eSpark-Backup/ezlo-irblaster/docs/Client's Original Design/irblaster_revB/3D/irblaster_revb_top.png

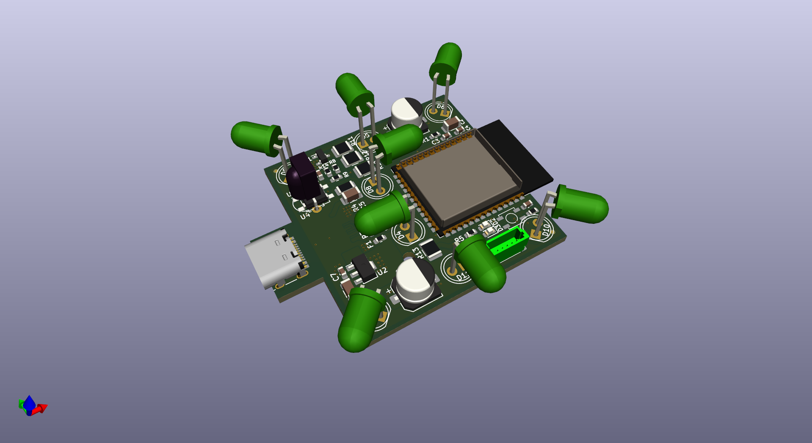
docs/Client's Original Design/irblaster_revB/3D/irblaster_revb_top.png
