eSpark-Backup/ezlo-irblaster/Deliverables/Renderings/3D_Top_View.PNG

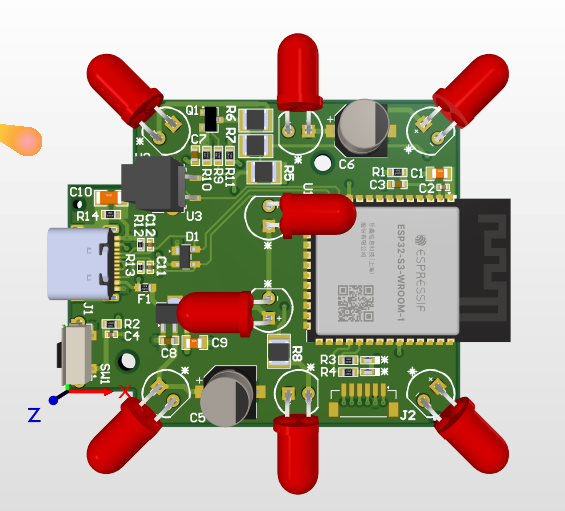
Deliverables/Renderings/3D_Top_View.PNG
