eSpark-Backup/ezlo-irblaster/Deliverables/Renderings/2D_C_View.PNG

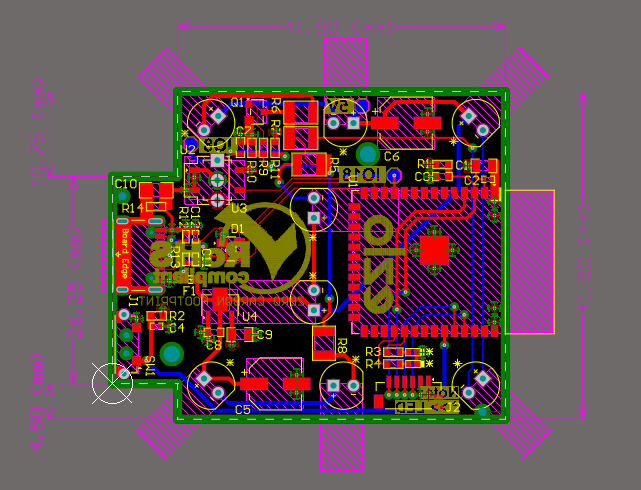
Deliverables/Renderings/2D_C_View.PNG
