eSpark-Backup/ezlo-irblaster/Deliverables/Renderings/3D_Bottom_View.PNG

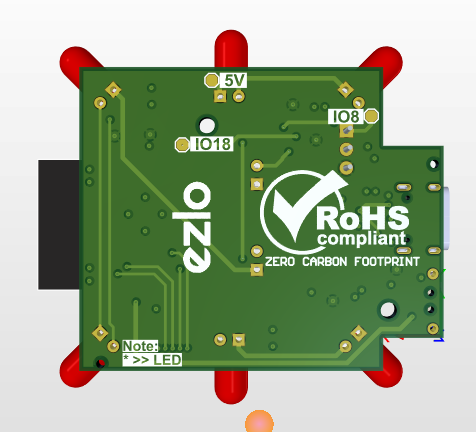
Deliverables/Renderings/3D_Bottom_View.PNG
