eSpark-Backup/ezlo-irblaster/Deliverables/Renderings/3D_Isometric_View.PNG

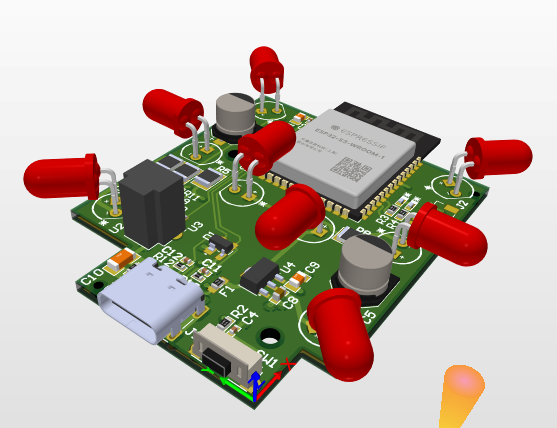
Deliverables/Renderings/3D_Isometric_View.PNG
