eSpark-Backup/ezlo-irblaster/Deliverables/BOM/eSpark_BOM.xlsx

Sheet: 20 Boards
 |  | Component list |  | Bill of Materials for Project [IR_blaster]
 |  | Source Data From: |  | IR_blaster
 |  | Project: |  | IR_blaster
 |  | Variant: |  | None
# | Item Type | Designator | Description | Footprint | Manufacturer Part Number | Manufacturer | Alternate Part Number | LCSC Part Number | Value | Quantity | Quantity (20 Boards) | MOQ (20 Boards) | Links | Unit Cost (20 Boards) | Total Cost (20 Boards) | Remarks | Reviewer Remarks
1 | Capacitor | C1, C9 | CAP CER 22UF 25V X5R 0805 | Cap-0805 | CL21A226MAYNNNE | Samsung | - | C602037 | 22uF | 2 | 40 | 60 | LCSC (https://www.lcsc.com/product-detail/Multilayer-Ceramic-Capacitors-MLCC-SMD-SMT_Samsung-Electro-Mechanics-CL21A226MAYNNNE_C602037.html) | $0.0235 | $1.4100
2 | Capacitor | C2, C4 | CAP CER 0.1UF 50V X5R 0402 | Cap-0402 | ~~C1005X5R1H104K050BB~~ | TDK | 0402B104K500CT | C152814 | 0.1uF | 2 | 40 | 100 | LCSC (https://www.lcsc.com/product-detail/Multilayer-Ceramic-Capacitors-MLCC-SMD-SMT_Walsin-Tech-Corp-0402B104K500CT_C152814.html) | $0.0020 | $0.2000
3 | Capacitor | C3 | CAP CER 1UF 25V X5R 0603 | Cap-0603 | CC0603KRX5R8BB105 | Yageo |  | C14664 | 1uF | 1 | 20 | 100 | LCSC (https://www.lcsc.com/product-detail/Multilayer-Ceramic-Capacitors-MLCC-SMD-SMT_YAGEO-CC0603KRX5R8BB105_C14664.html) | $0.0046 | $0.4600
4 | Capacitor | C5, C6 | 220uF 5.4mm 10V 6.3mm ±20% SMD,D6.3xL5.4mm Aluminum Electrolytic Capacitors - SMD ROHS | Custom | RT1A221M0605 | ROQANG | - | C267466 | 220uF | 2 | 40 | 60 | LCSC (https://www.lcsc.com/product-detail/Aluminum-Electrolytic-Capacitors-SMD_ROQANG-RT1A221M0605_C267466.html) | $0.0329 | $1.9740
5 | Capacitor | C7 | CAP CER 4.7UF 25V X5R 0603 | Cap-0603 | CL10A475KA8NQNC | Samsung | - | C69335 | 4.7UF | 1 | 20 | 40 | LCSC (https://www.lcsc.com/product-detail/Multilayer-Ceramic-Capacitors-MLCC-SMD-SMT_Samsung-Electro-Mechanics-CL10A475KA8NQNC_C69335.html) | $0.0173 | $0.6920
6 | Capacitor | C8 | CAP CER 10UF 25V X5R 0603 | Cap-0603 | ~~C1608X5R1E106M080AC~~ | TDK | CL10A106MA8NRNC | C96446 | 10uF | 1 | 20 | 40 | LCSC (https://www.lcsc.com/product-detail/Multilayer-Ceramic-Capacitors-MLCC-SMD-SMT_Samsung-Electro-Mechanics-CL10A106MA8NRNC_C96446.html) | $0.0234 | $0.9360
7 | Capacitor | C10 | CAP CER 4700PF 1KV X7R 1206 | Cap-1206 | CC1206KKX7RCBB472 | Yageo |  | C107198 | 4.7nF | 1 | 20 | 50 | LCSC (https://www.lcsc.com/product-detail/Multilayer-Ceramic-Capacitors-MLCC-SMD-SMT_YAGEO-CC1206KKX7RCBB472_C107198.html) | $0.0148 | $0.7400
8 | Capacitor | C11, C12 | DO Not Mount | Cap-0402 | - | - | - | - | - | 2 | 40 | - | - | - | - | DO NOT MOUNT
9 | Diode | D1 | ESD Suppressor TVS 5.5V 4-Pin(3+Tab) SOT-143 T/R | SOT-143-4_ | SP0503BAHTG | Littelfuse | - | C7074 | - | 1 | 20 | 25 | LCSC (https://www.lcsc.com/product-detail/TVS_Littelfuse-SP0503BAHTG_C7074.html) | $0.1760 | $4.4000
10 | Fuse | F1 | 6V 1A 50A 1W -40℃~+85℃ 2A 9mΩ 0.5s 80mΩ 0603 Resettable Fuses ROHS | fuse-0603 | BSMD0603L-100 | BHFUSE | - | C2757929 | - | 1 | 20 | 25 | LCSC (https://www.lcsc.com/product-detail/Resettable-Fuses_BHFUSE-BSMD0603L-100_C2757929.html) | $0.0716 | $1.7900
11 | Connector | J1 | 250mA 1 16 Female Type-C SMD USB Connectors ROHS | Custom | TYPE-C-31-M-12 | Korean Hroparts Elec | - | C165948 | - | 1 | 20 | 25 | LCSC (https://www.lcsc.com/product-detail/USB-Connectors_Korean-Hroparts-Elec-TYPE-C-31-M-12_C165948.html) | $0.2276 | $5.6900
12 | JST Connector | J2 | DNP | Custom | Voltlink Target | - | - | - | - | 1 | 20 | - | - | - | - | DO NOT MOUNT
13 | LED | LED1 | Green 520~535nm 0402 Light Emitting Diodes (LED) RoHS | LED-0402 | 16-213/GHC-YR1S1/3T | Everlight Elec | - | C74338 | - | 1 | 20 | 30 | LCSC (https://www.lcsc.com/product-detail/Light-Emitting-Diodes-LED_Everlight-Elec-16-213-GHC-YR1S1-3T_C74338.html) | $0.0660 | $1.9800
14 | LED | LED2 | LED RED CLEAR CHIP SMD | LED-0402 | ~~XZMDK68W-2~~ | SunLED | XL-1005SURC | C965790 | - | 1 | 20 | 100 | LCSC (https://www.lcsc.com/product-detail/Light-Emitting-Diodes-span-style-background-color-ff0-LED-span_XINGLIGHT-XL-1005SURC_C965790.html) | $0.0059 | $0.5900
15 | Infrared LED | LED3, LED4, LED5, LED6, LED7, LED8, LED9, LED10 | EMITTER IR 940NM 100MA RADIAL | IR333_A | IR333-A | Everlight | - | C95407 | - | 8 | 160 | 180 | LCSC (https://www.lcsc.com/product-detail/Infrared-IR-LEDs_Everlight-Elec-IR333-A_C95407.html) | $0.0481 | $8.6580
16 | Test Point | P2, P3, P4 | Test Point ON | Custom | - | - | - | - | - | 3 | 60 | - | - | - | - | DO NOT MOUNT
17 | Mosfet | Q1 | 20V 3A 40mΩ@4.5V,3A 700mW 780mV@250uA 29pF@10V N Channel 280pF@10V 2.9nC@4.5V -55℃~+150℃@(Tj) SOT-23-3L MOSFETs ROHS | SOT-23-3L_ | YJL2302B | Yangzhou Yangjie Elec Tech | - | C699316 | - | 1 | 20 | 40 | LCSC (https://www.lcsc.com/product-detail/MOSFETs_Yangzhou-Yangjie-Elec-Tech-YJL2302B_C699316.html) | $0.0287 | $1.1480
18 | Resistor | R1, R2, R10 | RES SMD 10K OHM 5% 1/5W 0603 | RES-0603 | ~~CRGH0603J10K~~ | TE Connectivity Holsworthy | CR0603JA0103G | C101254 | 10K | 3 | 60 | 100 | LCSC (https://www.lcsc.com/product-detail/Chip-Resistor-Surface-Mount_LIZ-Elec-CR0603JA0103G_C101254.html) | $0.0010 | $0.1000
19 | Resistor | R3, R4 | RES SMD 330R 100 mW 0603 | Res-0603 | RC0603JR-07330RL | Yageo | - | C105879 | 330R | 2 | 40 | 100 | LCSC (https://www.lcsc.com/product-detail/Chip-Resistor-Surface-Mount_YAGEO-RC0603JR-07330RL_C105879.html) | $0.0011 | $0.1100
20 | Resistor | R5, R6, R7, R8 | 500mW Thick Film Resistors 200V ±100ppm/℃ 27Ω 1210 Chip Resistor - SMD ROHS | Res_1210 | FRC1210F27R0TS | FOJAN | - | C2960734 | 27R | 4 | 80 | 100 | LCSC (https://www.lcsc.com/product-detail/Chip-Resistor-Surface-Mount_FOJAN-FRC1210F27R0TS_C2960734.html) | $0.0088 | $0.8800
21 | Resistor | R9, R11 | RES SMD 100 OHM 1% 1/10W 0603 | Res-0603 | RC0603FR-07100RL | Yageo |  | C105588 | 100R | 2 | 40 | 100 | LCSC (https://www.lcsc.com/product-detail/Chip-Resistor-Surface-Mount_YAGEO-RC0603FR-07100RL_C105588.html) | $0.0009 | $0.0900
22 | Resistor | R12, R13 | RES SMD 5.1 KOHM 1% 1/5W 0402 | Res-0402 | ~~ERJ-PA2F5101X~~ | Panasonic | RC-02W5101FT | C294638 | 5.1K | 2 | 40 | 100 | LCSC (https://www.lcsc.com/product-detail/Chip-Resistor-Surface-Mount_FH-Guangdong-Fenghua-Advanced-Tech-RC-02W5101FT_C294638.html) | $0.0004 | $0.0400
23 | Resistor | R14 | RES SMD 1M OHM 1% 1/10W 0603 | Res-0603 | RC0603FR-071ML | Yageo |  | C105578 | 1M | 1 | 20 | 100 | LCSC (https://www.lcsc.com/product-detail/Chip-Resistor-Surface-Mount_YAGEO-RC0603FR-071ML_C105578.html) | $0.0015 | $0.1500
24 | Switch | SW1 | 3.5mm 3.5mm SMDSplicing Black Rectangle button 50mA Surface Mount 7mm SPST 100MΩ 20000 12V 250gf@±50gf SMD Tactile Switches ROHS | Custom | YTS-B003-2A | YIYUAN | - | C2910695 | - | 1 | 20 | 40 | LCSC (https://www.lcsc.com/product-detail/Tactile-Switches_YIYUAN-YTS-B003-2A_C2910695.html) | $0.0180 | $0.7200
25 | Module | U1 | SMD MODULE, ESP32-S3, 4 MB SPI F | 41-SMD Module | ESP32-S3-WROOM-1-N4 | Espressif Systems | - | C2913197 | - | 1 | 20 | 22 | LCSC (https://www.lcsc.com/product-detail/WiFi-Modules_Espressif-Systems-ESP32-S3-WROOM-1-N4_C2913197.html) | $3.4046 | $74.9012
26 | IC | U2 | IRM-H6 Series External Dimensions 5 x 7 x 4 mm SMT Infrared Receiver | SMD-4,4x5mm | IRM-H638T/TR2 | Everlight | - | C91447 | - | 1 | 20 | 25 | LCSC (https://www.lcsc.com/product-detail/Infrared-remote-receiver_Everlight-Elec-IRM-H638T-TR2_C91447.html) | $0.2901 | $7.2525
27 | IC | U3 | SENSOR REMOTE REC 38.0KHZ 14M | SIP-3P-2.54mm | IRM-3638T | Everlight | - | C16216 | - | 1 | 20 | 25 | LCSC (https://www.lcsc.com/product-detail/Infrared-remote-receiver_Everlight-Elec-IRM-3638T_C16216.html) | $0.2118 | $5.2950
28 | IC | U4 | 600mA 60dB 500mV@(600mA) Fixed 3.3V~3.3V Positive 1 7V SOT-89(SOT-89-3) Linear Voltage Regulators (LDO) ROHS | SOT-89-3 | LR1107G-33-AB3-C-R | UTC(Unisonic Tech) | - | C171498 | - | 1 | 20 | 22 | LCSC (https://www.lcsc.com/product-detail/Linear-Voltage-Regulators-LDO_UTC-Unisonic-Tech-LR1107G-33-AB3-C-R_C171498.html) | $0.1418 | $3.1196
 |  |  |  |  |  |  |  |  |  |  |  | Total Component Cost |  |  | $123.33
 |  |  |  |  |  |  |  |  |  |  |  | Single Board Cost |  |  | $6.17

Sheet: 1000 Boards
 |  | Component list |  | Bill of Materials for Project [IR_blaster]
 |  | Source Data From: |  | IR_blaster
 |  | Project: |  | IR_blaster
 |  | Variant: |  | None
# | Item Type | Designator | Description | Footprint | Manufacturer Part Number | Manufacturer | Alternate Part Number | LCSC Part Number | Value | Quantity | Quantity (1000 Boards) | MOQ (1000 Boards) | Links | Unit Cost (1000 Boards) | Total Cost (1000 Boards) | Remarks | Reviewer Remarks
1 | Capacitor | C1, C9 | CAP CER 22UF 25V X5R 0805 | Cap-0805 | CL21A226MAYNNNE | Samsung | - | C602037 | 22uF | 2 | 2000 | 1060 | LCSC (https://www.lcsc.com/product-detail/Multilayer-Ceramic-Capacitors-MLCC-SMD-SMT_Samsung-Electro-Mechanics-CL21A226MAYNNNE_C602037.html) | $0.0156 | $16.5360
2 | Capacitor | C2, C4 | CAP CER 0.1UF 50V X5R 0402 | Cap-0402 | ~~C1005X5R1H104K050BB~~ | TDK | 0402B104K500CT | C152814 | 0.1uF | 2 | 2000 | 2100 | LCSC (https://www.lcsc.com/product-detail/Multilayer-Ceramic-Capacitors-MLCC-SMD-SMT_Walsin-Tech-Corp-0402B104K500CT_C152814.html) | $0.0015 | $3.1500
3 | Capacitor | C3 | CAP CER 1UF 25V X5R 0603 | Cap-0603 | CC0603KRX5R8BB105 | Yageo |  | C14664 | 1uF | 1 | 1000 | 1100 | LCSC (https://www.lcsc.com/product-detail/Multilayer-Ceramic-Capacitors-MLCC-SMD-SMT_YAGEO-CC0603KRX5R8BB105_C14664.html) | $0.0036 | $3.9600
4 | Capacitor | C5, C6 | 220uF 5.4mm 10V 6.3mm ±20% SMD,D6.3xL5.4mm Aluminum Electrolytic Capacitors - SMD ROHS | Custom | RT1A221M0605 | ROQANG | - | C267466 | 220uF | 2 | 2000 | 2060 | LCSC (https://www.lcsc.com/product-detail/Aluminum-Electrolytic-Capacitors-SMD_ROQANG-RT1A221M0605_C267466.html) | $0.0210 | $43.2600
5 | Capacitor | C7 | CAP CER 4.7UF 25V X5R 0603 | Cap-0603 | CL10A475KA8NQNC | Samsung | - | C69335 | 4.7UF | 1 | 1000 | 1060 | LCSC (https://www.lcsc.com/product-detail/Multilayer-Ceramic-Capacitors-MLCC-SMD-SMT_Samsung-Electro-Mechanics-CL10A475KA8NQNC_C69335.html) | $0.0120 | $12.7200
6 | Capacitor | C8 | CAP CER 10UF 25V X5R 0603 | Cap-0603 | ~~C1608X5R1E106M080AC~~ | TDK | CL10A106MA8NRNC | C96446 | 10uF | 1 | 1000 | 1060 | LCSC (https://www.lcsc.com/product-detail/Multilayer-Ceramic-Capacitors-MLCC-SMD-SMT_Samsung-Electro-Mechanics-CL10A106MA8NRNC_C96446.html) | $0.0158 | $16.7480
7 | Capacitor | C10 | CAP CER 4700PF 1KV X7R 1206 | Cap-1206 | CC1206KKX7RCBB472 | Yageo |  | C107198 | 4.7nF | 1 | 1000 | 1050 | LCSC (https://www.lcsc.com/product-detail/Multilayer-Ceramic-Capacitors-MLCC-SMD-SMT_YAGEO-CC1206KKX7RCBB472_C107198.html) | $0.0120 | $12.6000
8 | Capacitor | C11, C12 | DO Not Mount | Cap-0402 | - | - | - | - | - | 2 | 2000 |  | - |  | - | DO NOT MOUNT
9 | Diode | D1 | ESD Suppressor TVS 5.5V 4-Pin(3+Tab) SOT-143 T/R | SOT-143-4_ | SP0503BAHTG | Littelfuse | - | C7074 | - | 1 | 1000 | 1050 | LCSC (https://www.lcsc.com/product-detail/TVS_Littelfuse-SP0503BAHTG_C7074.html) | $0.1196 | $125.5800
10 | Fuse | F1 | 6V 1A 50A 1W -40℃~+85℃ 2A 9mΩ 0.5s 80mΩ 0603 Resettable Fuses ROHS | fuse-0603 | BSMD0603L-100 | BHFUSE | - | C2757929 | - | 1 | 1000 | 1050 | LCSC (https://www.lcsc.com/product-detail/Resettable-Fuses_BHFUSE-BSMD0603L-100_C2757929.html) | $0.0471 | $49.4550
11 | Connector | J1 | 250mA 1 16 Female Type-C SMD USB Connectors ROHS | Custom | TYPE-C-31-M-12 | Korean Hroparts Elec | - | C165948 | - | 1 | 1000 | 1050 | LCSC (https://www.lcsc.com/product-detail/USB-Connectors_Korean-Hroparts-Elec-TYPE-C-31-M-12_C165948.html) | $0.1074 | $112.7700
12 | JST Connector | J2 | DNP | Custom | Voltlink Target | - | - | - | - | 1 | 1000 | - | - | - | - | DO NOT MOUNT
13 | LED | LED1 | Green 520~535nm 0402 Light Emitting Diodes (LED) RoHS | LED-0402 | 16-213/GHC-YR1S1/3T | Everlight Elec | - | C74338 | - | 1 | 1000 | 1050 | LCSC (https://www.lcsc.com/product-detail/Light-Emitting-Diodes-LED_Everlight-Elec-16-213-GHC-YR1S1-3T_C74338.html) | $0.0488 | $51.2400
14 | LED | LED2 | LED RED CLEAR CHIP SMD | LED-0402 | ~~XZMDK68W-2~~ | SunLED | XL-1005SURC | C965790 | - | 1 | 1000 | 1100 | LCSC (https://www.lcsc.com/product-detail/Light-Emitting-Diodes-span-style-background-color-ff0-LED-span_XINGLIGHT-XL-1005SURC_C965790.html) | $0.0047 | $5.1700
15 | Infrared LED | LED3, LED4, LED5, LED6, LED7, LED8, LED9, LED10 | EMITTER IR 940NM 100MA RADIAL | IR333_A | IR333-A | Everlight | - | C95407 | - | 8 | 8000 | 1050 | LCSC (https://www.lcsc.com/product-detail/Infrared-IR-LEDs_Everlight-Elec-IR333-A_C95407.html) | $0.0387 | $40.6350
16 | Test Point | P2, P3, P4 | Test Point ON | Custom | - | - | - | - | - | 3 | 3000 |  | - |  | - | DO NOT MOUNT
17 | Mosfet | Q1 | 20V 3A 40mΩ@4.5V,3A 700mW 780mV@250uA 29pF@10V N Channel 280pF@10V 2.9nC@4.5V -55℃~+150℃@(Tj) SOT-23-3L MOSFETs ROHS | SOT-23-3L_ | YJL2302B | Yangzhou Yangjie Elec Tech | - | C699316 | - | 1 | 1000 | 1040 | LCSC (https://www.lcsc.com/product-detail/MOSFETs_Yangzhou-Yangjie-Elec-Tech-YJL2302B_C699316.html) | $0.0199 | $20.6960
18 | Resistor | R1, R2, R10 | RES SMD 10K OHM 5% 1/5W 0603 | RES-0603 | ~~CRGH0603J10K~~ | TE Connectivity Holsworthy | CR0603JA0103G | C101254 | 10K | 3 | 3000 | 3100 | LCSC (https://www.lcsc.com/product-detail/Chip-Resistor-Surface-Mount_LIZ-Elec-CR0603JA0103G_C101254.html) | $0.0008 | $2.4800
19 | Resistor | R3, R4 | RES SMD 330R 100 mW 0603 | Res-0603 | RC0603JR-07330RL | Yageo | - | C105879 | 330R | 2 | 2000 | 2100 | LCSC (https://www.lcsc.com/product-detail/Chip-Resistor-Surface-Mount_YAGEO-RC0603JR-07330RL_C105879.html) | $0.0008 | $1.6800
20 | Resistor | R5, R6, R7, R8 | 500mW Thick Film Resistors 200V ±100ppm/℃ 27Ω 1210 Chip Resistor - SMD ROHS | Res_1210 | FRC1210F27R0TS | FOJAN | - | C2960734 | 27R | 4 | 4000 | 4050 | LCSC (https://www.lcsc.com/product-detail/Chip-Resistor-Surface-Mount_FOJAN-FRC1210F27R0TS_C2960734.html) | $0.0061 | $24.7050
21 | Resistor | R9, R11 | RES SMD 100 OHM 1% 1/10W 0603 | Res-0603 | RC0603FR-07100RL | Yageo | - | C105588 | 100R | 2 | 2000 | 2100 | LCSC (https://www.lcsc.com/product-detail/Chip-Resistor-Surface-Mount_YAGEO-RC0603FR-07100RL_C105588.html) | $0.0007 | $1.4700
22 | Resistor | R12, R13 | RES SMD 5.1 KOHM 1% 1/5W 0402 | Res-0402 | ~~ERJ-PA2F5101X~~ | Panasonic | RC-02W5101FT | C294638 | 5.1K | 2 | 2000 | 2100 | LCSC (https://www.lcsc.com/product-detail/Chip-Resistor-Surface-Mount_FH-Guangdong-Fenghua-Advanced-Tech-RC-02W5101FT_C294638.html) | $0.0004 | $0.8400
23 | Resistor | R14 | RES SMD 1M OHM 1% 1/10W 0603 | Res-0603 | RC0603FR-071ML | Yageo | - | C105578 | 1M | 1 | 1000 | 1100 | LCSC (https://www.lcsc.com/product-detail/Chip-Resistor-Surface-Mount_YAGEO-RC0603FR-071ML_C105578.html) | $0.0012 | $1.3200
24 | Switch | SW1 | 3.5mm 3.5mm SMDSplicing Black Rectangle button 50mA Surface Mount 7mm SPST 100MΩ 20000 12V 250gf@±50gf SMD Tactile Switches ROHS | Custom | YTS-B003-2A | YIYUAN | - | C2910695 | - | 1 | 1000 | 1060 | LCSC (https://www.lcsc.com/product-detail/Tactile-Switches_YIYUAN-YTS-B003-2A_C2910695.html) | $0.0122 | $12.9320
25 | Module | U1 | SMD MODULE, ESP32-S3, 4 MB SPI F | 41-SMD Module | ESP32-S3-WROOM-1-N4 | Espressif Systems | - | C2913197 | - | 1 | 1000 | 1020 | LCSC (https://www.lcsc.com/product-detail/WiFi-Modules_Espressif-Systems-ESP32-S3-WROOM-1-N4_C2913197.html) | $3.3330 | $3399.6600 | Less Stock On LCSC ETA request sended
26 | IC | U2 | IRM-H6 Series External Dimensions 5 x 7 x 4 mm SMT Infrared Receiver | SMD-4,4x5mm | IRM-H638T/TR2 | Everlight | - | C91447 | - | 1 | 1000 | 1030 | LCSC (https://www.lcsc.com/product-detail/Infrared-remote-receiver_Everlight-Elec-IRM-H638T-TR2_C91447.html) | $0.1737 | $178.9110
27 | IC | U3 | SENSOR REMOTE REC 38.0KHZ 14M | SIP-3P-2.54mm | IRM-3638T | Everlight | - | C16216 | - | 1 | 1000 | 1030 | LCSC (https://www.lcsc.com/product-detail/Infrared-remote-receiver_Everlight-Elec-IRM-3638T_C16216.html) | $0.1326 | $136.5780
28 | IC | U4 | 600mA 60dB 500mV@(600mA) Fixed 3.3V~3.3V Positive 1 7V SOT-89(SOT-89-3) Linear Voltage Regulators (LDO) ROHS | SOT-89-3 | LR1107G-33-AB3-C-R | UTC(Unisonic Tech) | - | C171498 | - | 1 | 1000 | 1030 | LCSC (https://www.lcsc.com/product-detail/Linear-Voltage-Regulators-LDO_UTC-Unisonic-Tech-LR1107G-33-AB3-C-R_C171498.html) | $0.0960 | $98.8800
 |  |  |  |  |  |  |  |  |  |  |  | Total Component Cost |  |  | $4373.98
 |  |  |  |  |  |  |  |  |  |  |  | Single Board Cost |  |  | $4.37

Sheet: 5000 Boards
 |  | Component list |  | Bill of Materials for Project [IR_blaster]
 |  | Source Data From: |  | IR_blaster
 |  | Project: |  | IR_blaster
 |  | Variant: |  | None
# | Item Type | Designator | Description | Footprint | Manufacturer Part Number | Manufacturer | Alternate Part Number | LCSC Part Number | Value | Quantity | Quantity (5000 Boards) | MOQ (5000 Boards) | Links | Unit Cost (5000 Boards) | Total Cost (5000 Boards) | Remarks | Reviewer Remarks
1 | Capacitor | C1, C9 | CAP CER 22UF 25V X5R 0805 | Cap-0805 | CL21A226MAYNNNE | Samsung | - | C602037 | 22uF | 2 | 10000 | 10100 | LCSC (https://www.lcsc.com/product-detail/Multilayer-Ceramic-Capacitors-MLCC-SMD-SMT_Samsung-Electro-Mechanics-CL21A226MAYNNNE_C602037.html) | $0.0130 | $131.3000
2 | Capacitor | C2, C4 | CAP CER 0.1UF 50V X5R 0402 | Cap-0402 | ~~C1005X5R1H104K050BB~~ | TDK | 0402B104K500CT | C152814 | 0.1uF | 2 | 10000 | 10100 | LCSC (https://www.lcsc.com/product-detail/Multilayer-Ceramic-Capacitors-MLCC-SMD-SMT_Walsin-Tech-Corp-0402B104K500CT_C152814.html) | $0.0011 | $11.1100
3 | Capacitor | C3 | CAP CER 1UF 25V X5R 0603 | Cap-0603 | CC0603KRX5R8BB105 | Yageo |  | C14664 | 1uF | 1 | 5000 | 5100 | LCSC (https://www.lcsc.com/product-detail/Multilayer-Ceramic-Capacitors-MLCC-SMD-SMT_YAGEO-CC0603KRX5R8BB105_C14664.html) | $0.0032 | $16.3200
4 | Capacitor | C5, C6 | 220uF 5.4mm 10V 6.3mm ±20% SMD,D6.3xL5.4mm Aluminum Electrolytic Capacitors - SMD ROHS | Custom | RT1A221M0605 | ROQANG | - | C267466 | 220uF | 2 | 10000 | 10100 | LCSC (https://www.lcsc.com/product-detail/Aluminum-Electrolytic-Capacitors-SMD_ROQANG-RT1A221M0605_C267466.html) | $0.0191 | $192.9100
5 | Capacitor | C7 | CAP CER 4.7UF 25V X5R 0603 | Cap-0603 | CL10A475KA8NQNC | Samsung | - | C69335 | 4.7UF | 1 | 5000 | 5100 | LCSC (https://www.lcsc.com/product-detail/Multilayer-Ceramic-Capacitors-MLCC-SMD-SMT_Samsung-Electro-Mechanics-CL10A475KA8NQNC_C69335.html) | $0.0108 | $55.0800
6 | Capacitor | C8 | CAP CER 10UF 25V X5R 0603 | Cap-0603 | ~~C1608X5R1E106M080AC~~ | TDK | CL10A106MA8NRNC | C96446 | 10uF | 1 | 5000 | 5100 | LCSC (https://www.lcsc.com/product-detail/Multilayer-Ceramic-Capacitors-MLCC-SMD-SMT_Samsung-Electro-Mechanics-CL10A106MA8NRNC_C96446.html) | $0.0140 | $71.4000
7 | Capacitor | C10 | CAP CER 4700PF 1KV X7R 1206 | Cap-1206 | CC1206KKX7RCBB472 | Yageo |  | C107198 | 4.7nF | 1 | 5000 | 5100 | LCSC (https://www.lcsc.com/product-detail/Multilayer-Ceramic-Capacitors-MLCC-SMD-SMT_YAGEO-CC1206KKX7RCBB472_C107198.html) | $0.0105 | $53.5500
8 | Capacitor | C11, C12 | DO Not Mount | Cap-0402 | - | - | - | - | - | 2 | 10000 | - | - | - | - | DO NOT MOUNT
9 | Diode | D1 | ESD Suppressor TVS 5.5V 4-Pin(3+Tab) SOT-143 T/R | SOT-143-4_ | SP0503BAHTG | Littelfuse | - | C7074 | - | 1 | 5000 | 5050 | LCSC (https://www.lcsc.com/product-detail/TVS_Littelfuse-SP0503BAHTG_C7074.html) | $0.1128 | $569.6400
10 | Fuse | F1 | 6V 1A 50A 1W -40℃~+85℃ 2A 9mΩ 0.5s 80mΩ 0603 Resettable Fuses ROHS | fuse-0603 | BSMD0603L-100 | BHFUSE | - | C2757929 | - | 1 | 5000 | 5050 | LCSC (https://www.lcsc.com/product-detail/Resettable-Fuses_BHFUSE-BSMD0603L-100_C2757929.html) | $0.0413 | $208.5650
11 | Connector | J1 | 250mA 1 16 Female Type-C SMD USB Connectors ROHS | Custom | TYPE-C-31-M-12 | Korean Hroparts Elec | - | C165948 | - | 1 | 5000 | 5050 | LCSC (https://www.lcsc.com/product-detail/USB-Connectors_Korean-Hroparts-Elec-TYPE-C-31-M-12_C165948.html) | $0.1023 | $516.6150
12 | JST Connector | J2 | DNP | Custom | Voltlink Target | - | - | - | - | 1 | 5000 | - | - | - | - | DO NOT MOUNT
13 | LED | LED1 | Green 520~535nm 0402 Light Emitting Diodes (LED) RoHS | LED-0402 | 16-213/GHC-YR1S1/3T | Everlight Elec | - | C74338 | - | 1 | 5000 | 5050 | LCSC (https://www.lcsc.com/product-detail/Light-Emitting-Diodes-LED_Everlight-Elec-16-213-GHC-YR1S1-3T_C74338.html) | $0.0445 | $224.7250 | Less Stock On LCSC ETA request sended
14 | LED | LED2 | LED RED CLEAR CHIP SMD | LED-0402 | ~~XZMDK68W-2~~ | SunLED | XL-1005SURC | C965790 | - | 1 | 5000 | 5100 | LCSC (https://www.lcsc.com/product-detail/Light-Emitting-Diodes-span-style-background-color-ff0-LED-span_XINGLIGHT-XL-1005SURC_C965790.html) | $0.0040 | $20.4000
15 | Infrared LED | LED3, LED4, LED5, LED6, LED7, LED8, LED9, LED10 | EMITTER IR 940NM 100MA RADIAL | IR333_A | IR333-A | Everlight | - | C95407 | - | 8 | 40000 | 40100 | LCSC (https://www.lcsc.com/product-detail/Infrared-IR-LEDs_Everlight-Elec-IR333-A_C95407.html) | $0.0338 | $1355.3800 | Less Stock On LCSC ETA request sended
16 | Test Point | P2, P3, P4 | Test Point ON | Custom | - | - | - | - | - | 3 | 15000 | - | - | - | - | DO NOT MOUNT
17 | Mosfet | Q1 | 20V 3A 40mΩ@4.5V,3A 700mW 780mV@250uA 29pF@10V N Channel 280pF@10V 2.9nC@4.5V -55℃~+150℃@(Tj) SOT-23-3L MOSFETs ROHS | SOT-23-3L_ | YJL2302B | Yangzhou Yangjie Elec Tech | - | C699316 | - | 1 | 5000 | 5060 | LCSC (https://www.lcsc.com/product-detail/MOSFETs_Yangzhou-Yangjie-Elec-Tech-YJL2302B_C699316.html) | $0.0181 | $91.5860
18 | Resistor | R1, R2, R10 | RES SMD 10K OHM 5% 1/5W 0603 | RES-0603 | ~~CRGH0603J10K~~ | TE Connectivity Holsworthy | CR0603JA0103G | C101254 | 10K | 3 | 15000 | 15100 | LCSC (https://www.lcsc.com/product-detail/Chip-Resistor-Surface-Mount_LIZ-Elec-CR0603JA0103G_C101254.html) | $0.0006 | $9.0600
19 | Resistor | R3, R4 | RES SMD 330R 100 mW 0603 | Res-0603 | RC0603JR-07330RL | Yageo | - | C105879 | 330R | 2 | 10000 | 10100 | LCSC (https://www.lcsc.com/product-detail/Chip-Resistor-Surface-Mount_YAGEO-RC0603JR-07330RL_C105879.html) | $0.0007 | $7.0700
20 | Resistor | R5, R6, R7, R8 | 500mW Thick Film Resistors 200V ±100ppm/℃ 27Ω 1210 Chip Resistor - SMD ROHS | Res_1210 | FRC1210F27R0TS | FOJAN | - | C2960734 | 27R | 4 | 20000 | 20100 | LCSC (https://www.lcsc.com/product-detail/Chip-Resistor-Surface-Mount_FOJAN-FRC1210F27R0TS_C2960734.html) | $0.0055 | $110.5500 | Less Stock On LCSC ETA request sended
21 | Resistor | R9, R11 | RES SMD 100 OHM 1% 1/10W 0603 | Res-0603 | RC0603FR-07100RL | Yageo | - | C105588 | 100R | 2 | 10000 | 10100 | LCSC (https://www.lcsc.com/product-detail/Chip-Resistor-Surface-Mount_YAGEO-RC0603FR-07100RL_C105588.html) | $0.0006 | $6.0600
22 | Resistor | R12, R13 | RES SMD 5.1 KOHM 1% 1/5W 0402 | Res-0402 | ~~ERJ-PA2F5101X~~ | Panasonic | RC-02W5101FT | C294638 | 5.1K | 2 | 10000 | 10100 | LCSC (https://www.lcsc.com/product-detail/Chip-Resistor-Surface-Mount_FH-Guangdong-Fenghua-Advanced-Tech-RC-02W5101FT_C294638.html) | $0.0004 | $4.0400
23 | Resistor | R14 | RES SMD 1M OHM 1% 1/10W 0603 | Res-0603 | RC0603FR-071ML | Yageo | - | C105578 | 1M | 1 | 5000 | 5100 | LCSC (https://www.lcsc.com/product-detail/Chip-Resistor-Surface-Mount_YAGEO-RC0603FR-071ML_C105578.html) | $0.0011 | $5.6100
24 | Switch | SW1 | 3.5mm 3.5mm SMDSplicing Black Rectangle button 50mA Surface Mount 7mm SPST 100MΩ 20000 12V 250gf@±50gf SMD Tactile Switches ROHS | Custom | YTS-B003-2A | YIYUAN | - | C2910695 | - | 1 | 5000 | 5060 | LCSC (https://www.lcsc.com/product-detail/Tactile-Switches_YIYUAN-YTS-B003-2A_C2910695.html) | $0.0110 | $55.6600 | Less Stock On LCSC ETA request sended
25 | Module | U1 | SMD MODULE, ESP32-S3, 4 MB SPI F | 41-SMD Module | ESP32-S3-WROOM-1-N4 | Espressif Systems | - | C2913197 | - | 1 | 5000 | 5020 | LCSC (https://www.lcsc.com/product-detail/WiFi-Modules_Espressif-Systems-ESP32-S3-WROOM-1-N4_C2913197.html) | $3.3330 | $16731.6600 | Less Stock On LCSC ETA request sended
26 | IC | U2 | IRM-H6 Series External Dimensions 5 x 7 x 4 mm SMT Infrared Receiver | SMD-4,4x5mm | IRM-H638T/TR2 | Everlight | - | C91447 | - | 1 | 5000 | 5030 | LCSC (https://www.lcsc.com/product-detail/Infrared-remote-receiver_Everlight-Elec-IRM-H638T-TR2_C91447.html) | $0.1632 | $820.8960
27 | IC | U3 | SENSOR REMOTE REC 38.0KHZ 14M | SIP-3P-2.54mm | IRM-3638T | Everlight | - | C16216 | - | 1 | 5000 | 5030 | LCSC (https://www.lcsc.com/product-detail/Infrared-remote-receiver_Everlight-Elec-IRM-3638T_C16216.html) | $0.1172 | $589.5160
28 | IC | U4 | 600mA 60dB 500mV@(600mA) Fixed 3.3V~3.3V Positive 1 7V SOT-89(SOT-89-3) Linear Voltage Regulators (LDO) ROHS | SOT-89-3 | LR1107G-33-AB3-C-R | UTC(Unisonic Tech) | - | C171498 | - | 1 | 5000 | 5030 | LCSC (https://www.lcsc.com/product-detail/Linear-Voltage-Regulators-LDO_UTC-Unisonic-Tech-LR1107G-33-AB3-C-R_C171498.html) | $0.0960 | $482.8800 | Less Stock On LCSC ETA request sended
 |  |  |  |  |  |  |  |  |  |  |  | Total Component Cost |  |  | $22341.58
 |  |  |  |  |  |  |  |  |  |  |  | Single Board Cost |  |  | $4.47
