eSpark-Backup/ezlo-irblaster/docs/Client's Original Design/irblaster_revB/BOM/BOM revA.xls

Bill of material - Ezlo IR Blaster revA (updated 28-mar-2022)
Qty | Reference(s) | Value | Voltage | LibPart | Footprint | Datasheet | LCSC | PN | LCSC cost/unit @10K | Subtotal
1 | C1 | 4.7nF |  | Device:C | Capacitor_SMD:C_1206_3216Metric | ~ | C107198 | CC1206KKX7RCBB472 | 0.0171 | 0.0171
2 | C2, C9 | 22uF |  | Device:C | Capacitor_SMD:C_1206_3216Metric | ~ | C408152 | GRM31CR70J226KE19L | 0.1522 | 0.3044
1 | C3 | 1uF |  | Device:C | Capacitor_SMD:C_0603_1608Metric | ~ | C1592 | CL10A105KO8NNNC | 0.0023 | 0.0023
2 | C4, C8 | 0.1uF |  | Device:C | Capacitor_SMD:C_0603_1608Metric | ~ | C24452 | CL10B104JB8NNNC | 0.0065 | 0.013
2 | C5, C6 | TBD | DNP | Device:C | Capacitor_SMD:C_0603_1608Metric | ~ | DNP | DNP | 0 | 0
1 | C7 | 10uF | 16V | Device:C | Capacitor_SMD:C_0603_1608Metric | ~ | C92487 | CL10A106MO8NQNC | 0.0111 | 0.0111
2 | C10, C11 | 220uF | 10V | Device:C_Polarized_US | Capacitor_SMD:CP_Elec_6.3x5.4 | ~ | C267466 | RT1A221M0605 | 0.0189 | 0.0378
1 | C12 | 4.7uF | 10V | Device:C | Capacitor_SMD:C_0603_1608Metric | ~ | C1705 | CL10A475KP8NNNC | 0.0036 | 0.0036
1 | D1 | SP0503BAHT |  | Power_Protection:SP0503BAHT | Package_TO_SOT_SMD:SOT-143 | http://www.littelfuse.com/~/media/files/littelfuse/technical%20resources/documents/data%20sheets/sp05xxba.pdf | C2682275 | TPSP0503BAHTG | 0.0605 | 0.0605
1 | D2 | RED |  | Device:LED | LED_SMD:LED_0603_1608Metric | ~ | C90692 | NCD0603R2 | 0.0134 | 0.0134
1 | D3 | GREEN |  | Device:LED | LED_SMD:LED_0603_1608Metric | ~ | C84267 | NCD0603G1 | 0.0113 | 0.0113
8 | D4, D5, D6, D7, D8, D9, D10, D11 | IR333-A |  | Device:LED_Filled | LED_THT:LED_D5.0mm | https://datasheet.lcsc.com/lcsc/1810151820_Everlight-Elec-IR333-A_C95407.pdf | C95407 | IR333-A | 0.0418 | 0.3344
1 | F1 | 1A |  | Device:Polyfuse | Fuse:Fuse_0603_1608Metric | ~ | C2757929 | BSMD0603L-100 | 0.0481 | 0.0481
2 | H1, H2 | MountingHole | DNP | Mechanical:MountingHole | MountingHole:MountingHole_2.2mm_M2 | ~ | DNP | DNP | 0 | 0
1 | J1 | USB_C_Receptacle_USB2.0 |  | voltlog:USB_C_Receptacle_USB2.0 | Connector_USB:USB_C_Receptacle_HRO_TYPE-C-31-M-12 | https://www.usb.org/sites/default/files/documents/usb_type-c.zip | C165948 | TYPE-C-31-M-12 | 0.1777 | 0.1777
1 | J2 | VoltLink_target | DNP | voltlog:VoltLink_target | Voltlog:VoltLink-vertical |  | DNP | DNP | 0 | 0
1 | N1 | Housing | DNP | Mechanical:Housing |  | ~ | DNP | DNP | 0 | 0
1 | Q1 | YJL2302B |  | Transistor_FET:DMG2302U | Package_TO_SOT_SMD:SOT-23 | https://www.21yangjie.com/ggs/mosfet/zdymosfet/YJL2302B.pdf | C699316 | YJL2302B | 0.0138 | 0.0138
3 | R1, R7, R14 | 10K |  | Device:R_US | Resistor_SMD:R_0603_1608Metric | ~ |  | GENERIC 1% | 0.0007 | 0.0021
1 | R2 | 1M |  | Device:R_US | Resistor_SMD:R_1206_3216Metric | ~ |  | GENERIC 1% | 0.0021 | 0.0021
2 | R3, R4 | 5K1 |  | Device:R_US | Resistor_SMD:R_0603_1608Metric | ~ |  | GENERIC 1% | 0.0007 | 0.0014
2 | R5, R6 | 330R |  | Device:R_US | Resistor_SMD:R_0603_1608Metric | ~ |  | GENERIC 1% | 0.0007 | 0.0014
2 | R8, R9 | 100R |  | Device:R_US | Resistor_SMD:R_0603_1608Metric | ~ |  | GENERIC 1% | 0.0007 | 0.0014
4 | R10, R11, R12, R13 | 27R |  | Device:R_US | Resistor_SMD:R_1210_3225Metric | ~ |  | GENERIC 1% | 0.0064 | 0.0256
1 | SW1 | USER |  | Switch:SW_Push | Voltlog:TS-1075S | ~ | C492874 | TS-1075S-A2B2-D4 | 0.0319 | 0.0319
1 | U1 | ESP32-S3-WROOM-1 |  | Espressif:ESP32-S3-WROOM-1 | Espressif:ESP32-S3-WROOM-1 |  | C2913197 | ESP32-S3-WROOM-1 | 3.29 | 3.29 | <- Digikey fixed prixing, direct purchase from Espressif is likely lower than this
1 | U2 | LR1107 |  | voltlog:LR1107 | Package_TO_SOT_SMD:SOT-89-3 | https://datasheet.lcsc.com/lcsc/1809251634_UTC-Unisonic-Tech-LR1107G-33-AB3-C-R_C171498.pdf | C171498 | LR1107G-33-AB3-C-R | 0.1318 | 0.1318
1 | U3 | IRM-H638T/TR2 |  | voltlog:IRM-H638T | Package_SO:SO-4_4.4x4.3mm_P2.54mm | https://datasheet.lcsc.com/lcsc/1810121714_Everlight-Elec-IRM-H638T-TR2_C91447.pdf | C91447 | IRM-H638T/TR2 | 0.1786 | 0.1786
1 | U4 | IRM-3638T |  | Interface_Optical:TSOP382xx | OptoDevice:Vishay_MINICAST-3Pin | https://datasheet.lcsc.com/lcsc/2112201230_Everlight-Elec-IRM-3638T_C16216.pdf | C16216 | IRM-3638T | 0 | 0
1 | PCB |  |  |  |  |  |  |  | 0.225 | 0.225
 |  |  |  |  |  |  |  |  | TOTAL | 4.9398 | USD
 | Does not include assembly cost, enclosure + fastening hw cost, packaging, user manual, any licensing for USB or Bluetooth, EMC testing
