eSpark-Backup/ezlo-irblaster/docs/Client's Original Design/irblaster_revB/BOM/IRBlaster_BOM_revB.xlsx

BOM IR Blaster revB - list updated 3-Oct-2022 (prices updated 28-mar-2022)
Ref | Qnty | Value | Voltage | Footprint | Description | Assembly | LCSC # | Mfr PN | LCSC cost/unit @10K | Subtotal
C1, | 1 | 4.7nF |  | Resistor_SMD:R_0805_2012Metric | Unpolarized capacitor | YES | C107198 | CC1206KKX7RCBB472 | 0.0171 | 0.0171
C2, C9, | 2 | 22uF |  | Capacitor_SMD:C_1206_3216Metric | Unpolarized capacitor | YES | C408152 | GRM31CR70J226KE19L | 0.1522 | 0.3044
C3, | 1 | 1uF |  | Capacitor_SMD:C_0402_1005Metric | Unpolarized capacitor | YES | C1592 | CL10A105KO8NNNC | 0.0023 | 0.0023
C4, C8, | 2 | 0.1uF |  | Capacitor_SMD:C_0402_1005Metric | Unpolarized capacitor | YES | C24452 | CL10B104JB8NNNC | 0.0065 | 0.013
C5, C6, | 2 | TBD |  | Capacitor_SMD:C_0402_1005Metric | Unpolarized capacitor | DNP |  |  | 0 | 0
C7, | 1 | 10uF | 16V | Capacitor_SMD:C_0603_1608Metric | Unpolarized capacitor | YES | C92487 | CL10A106MO8NQNC | 0.0111 | 0.0111
C10, C11, | 2 | 220uF | 10V | Capacitor_SMD:CP_Elec_6.3x5.4 | Polarized capacitor, US symbol | YES | C267466 | RT1A221M0605 | 0.0189 | 0.0378
C12, | 1 | 4.7uF |  | Capacitor_SMD:C_0402_1005Metric | Unpolarized capacitor | YES | C1705 | CL10A475KP8NNNC | 0.0036 | 0.0036
D1, | 1 | SP0503BAHT |  | Package_TO_SOT_SMD:SOT-143 | TVS Diode Array, 5.5V Standoff, 3 Channels, SOT-143 package | YES | C2682275 | TPSP0503BAHTG | 0.0605 | 0.0605
D2, | 1 | RED |  | LED_SMD:LED_0603_1608Metric | Light emitting diode | YES | C90692 | NCD0603R2 | 0.0134 | 0.0134
D3, | 1 | GREEN |  | LED_SMD:LED_0603_1608Metric | Light emitting diode | YES | C84267 | NCD0603G1 | 0.0113 | 0.0113
D4, D5, D6, D7, D8, D9, D10, D11, | 8 | IR333-A |  | LED_THT:LED_D5.0mm | Light emitting diode, filled shape | YES | C95407 | IR333-A | 0.0418 | 0.3344
F1, | 1 | 1A |  | Fuse:Fuse_0603_1608Metric | Resettable fuse, polymeric positive temperature coefficient | YES | C2757929 | BSMD0603L-100 | 0.0481 | 0.0481
J1, | 1 | USB_C_Receptacle_USB2.0 |  | Connector_USB:USB_C_Receptacle_HRO_TYPE-C-31-M-12 | USB 2.0-only Type-C Receptacle connector | YES | C165948 | TYPE-C-31-M-12 | 0.1777 | 0.1777
J2, | 1 | VoltLink_target |  | Voltlog:VoltLink-vertical | Voltlog Link ESP programming header, pinout designed for target side. | DNP |  |  | 0 | 0
Q1, | 1 | YJL2302B |  | Package_TO_SOT_SMD:SOT-23 | 4.2A Id, 20V Vds, N-Channel MOSFET, SOT-23 | YES | C699316 | YJL2302B | 0.0138 | 0.0138
R1, R7, R14, | 3 | 10K |  | Resistor_SMD:R_0402_1005Metric | Resistor, US symbol | YES |  | GENERIC 1% | 0.0007 | 0.0021
R2, | 1 | 1M |  | Resistor_SMD:R_0805_2012Metric | Resistor, US symbol | YES |  | GENERIC 1% | 0.0021 | 0.0021
R3, R4, | 2 | 5K1 |  | Resistor_SMD:R_0402_1005Metric | Resistor, US symbol | YES |  | GENERIC 1% | 0.0007 | 0.0014
R5, R6, | 2 | 330R |  | Resistor_SMD:R_0402_1005Metric | Resistor, US symbol | YES |  | GENERIC 1% | 0.0007 | 0.0014
R8, R9, | 2 | 100R |  | Resistor_SMD:R_0402_1005Metric | Resistor, US symbol | YES |  | GENERIC 1% | 0.0007 | 0.0014
R10, R11, R12, R13, | 4 | 27R |  | Resistor_SMD:R_1210_3225Metric | Resistor, US symbol | YES |  | GENERIC 1% | 0.0064 | 0.0256
SW1, | 1 | USER |  | Ezlo:Switch_YTS-B003-2A | Push button switch, generic, two pins | YES | C2910695 | YTS-B003-2A | 0.0107 | 0.0107
U1, | 1 | ESP32-S3-WROOM-1 |  | Espressif:ESP32-S3-WROOM-1 |  | YES | C2913197 | ESP32-S3-WROOM-1 | 3.29 | 3.29 | <- Digikey fixed prixing, direct purchase from Espressif is likely lower than this
U2, | 1 | LR1107 |  | Package_TO_SOT_SMD:SOT-89-3 | 600mA FAST ULTRA LOW Dropout Regulator | YES | C171498 | LR1107G-33-AB3-C-R | 0.1318 | 0.1318
U3, | 1 | IRM-H638T/TR2 |  | Package_SO:SO-4_4.4x4.3mm_P2.54mm | Photo Modules for PCM Remote Control Systems | YES | C91447 | IRM-H638T/TR2 | 0.1786 | 0.1786 | <- We can assemble one or the other U3 vs U4 depending on which one is cheaper and/or available
U4, | 1 | IRM-3638T |  | OptoDevice:Vishay_MINICAST-3Pin | Photo Modules for PCM Remote Control Systems | DNP | C16216 | IRM-3638T | 0 | 0
N1, | 1 | Housing |  |  | Housing | YES |  | custom | 0 | 0
H1, H2, | 2 | MountingHole |  | MountingHole:MountingHole_2.2mm_M2 | Screws Philips M2x4mm Self Tapping | YES |  |  | 0.01 | 0.02
PCB | 1 |  |  | PCB FR4 2L TG130 1.6mm HASL 49.75*41.5mm |  |  |  | custom | 0 | 0
 |  |  |  |  |  |  |  |  | TOTAL | $4.7136
