eSpark-Backup/ezlo-irblaster/docs/Client's Original Design/irblaster_revB/irblaster.csv

# | Reference | Qty | Value | Footprint
1 | C1 | 1 | 4.7nF | Resistor_SMD:R_0805_2012Metric
2 | C2, C9 | 2 | 22uF | Capacitor_SMD:C_1206_3216Metric
3 | C3 | 1 | 1uF | Capacitor_SMD:C_0402_1005Metric
4 | C4, C8 | 2 | 0.1uF | Capacitor_SMD:C_0402_1005Metric
5 | C5, C6 | 2 | TBD | Capacitor_SMD:C_0402_1005Metric
6 | C7 | 1 | 10uF | Capacitor_SMD:C_0603_1608Metric
7 | C10, C11 | 2 | 220uF | Capacitor_SMD:CP_Elec_6.3x5.4
8 | C12 | 1 | 4.7uF | Capacitor_SMD:C_0402_1005Metric
9 | D1 | 1 | SP0503BAHT | Package_TO_SOT_SMD:SOT-143
10 | D2 | 1 | RED | LED_SMD:LED_0603_1608Metric
11 | D3 | 1 | GREEN | LED_SMD:LED_0603_1608Metric
12 | D4, D5, D6, D7, D8, D9, D10, D11 | 8 | IR333-A | LED_THT:LED_D5.0mm
13 | F1 | 1 | 1A | Fuse:Fuse_0603_1608Metric
14 | H1, H2 | 2 | MountingHole | MountingHole:MountingHole_2.2mm_M2
15 | J1 | 1 | USB_C_Receptacle_USB2.0 | Connector_USB:USB_C_Receptacle_HRO_TYPE-C-31-M-12
16 | J2 | 1 | VoltLink_target | Voltlog:VoltLink-vertical
17 | N1 | 1 | Housing
18 | Q1 | 1 | YJL2302B | Package_TO_SOT_SMD:SOT-23
19 | R1, R7, R14 | 3 | 10K | Resistor_SMD:R_0402_1005Metric
20 | R2 | 1 | 1M | Resistor_SMD:R_0805_2012Metric
21 | R3, R4 | 2 | 5K1 | Resistor_SMD:R_0402_1005Metric
22 | R5, R6 | 2 | 330R | Resistor_SMD:R_0402_1005Metric
23 | R8, R9 | 2 | 100R | Resistor_SMD:R_0402_1005Metric
24 | R10, R11, R12, R13 | 4 | 27R | Resistor_SMD:R_1210_3225Metric
25 | SW1 | 1 | USER | Ezlo:Switch_YTS-B003-2A
26 | TP1 | 1 | +5V | TestPoint:TestPoint_Pad_D1.0mm
27 | TP2 | 1 | IO18 | TestPoint:TestPoint_Pad_D1.0mm
28 | TP3 | 1 | IO8 | TestPoint:TestPoint_Pad_D1.0mm
29 | U1 | 1 | ESP32-S3-WROOM-1 | Espressif:ESP32-S3-WROOM-1
30 | U2 | 1 | LR1107 | Package_TO_SOT_SMD:SOT-89-3
31 | U3 | 1 | IRM-H638T/TR2 | Package_SO:SO-4_4.4x4.3mm_P2.54mm
32 | U4 | 1 | IRM-3638T | OptoDevice:Vishay_MINICAST-3Pin
