eSpark-Backup/ezlo-irblaster/docs/Client's Original Design/irblaster_revB/3D/irblaster_revB.step

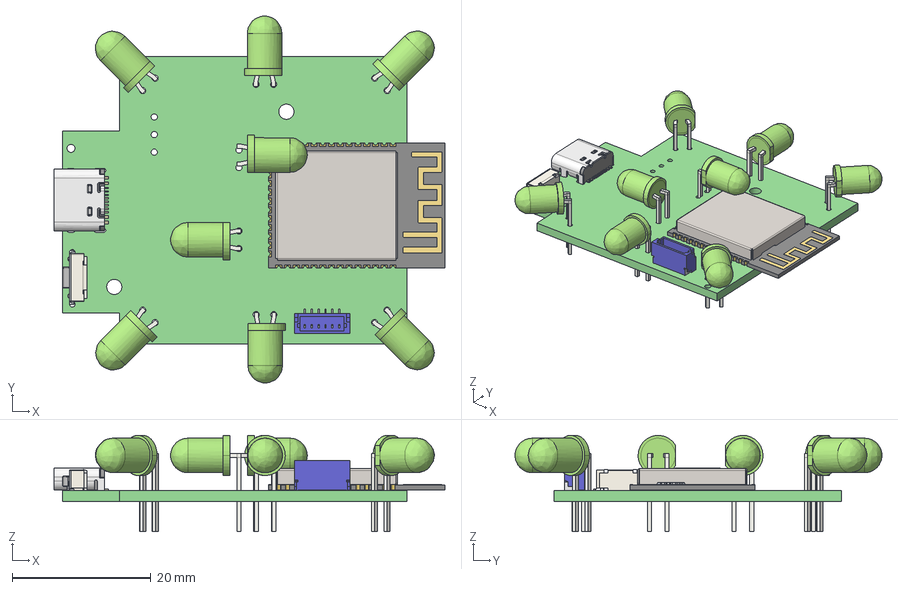
[picture p8: CAD file, 2022-12-01]
docs/Client's Original Design/irblaster_revB/3D/irblaster_revB.step
56.5 x 53.0 x 13.9 mm
irblaster PCB
