eSpark-Backup/ezlo-irblaster/Deliverables/Supporting_files/iR-Blaster.step

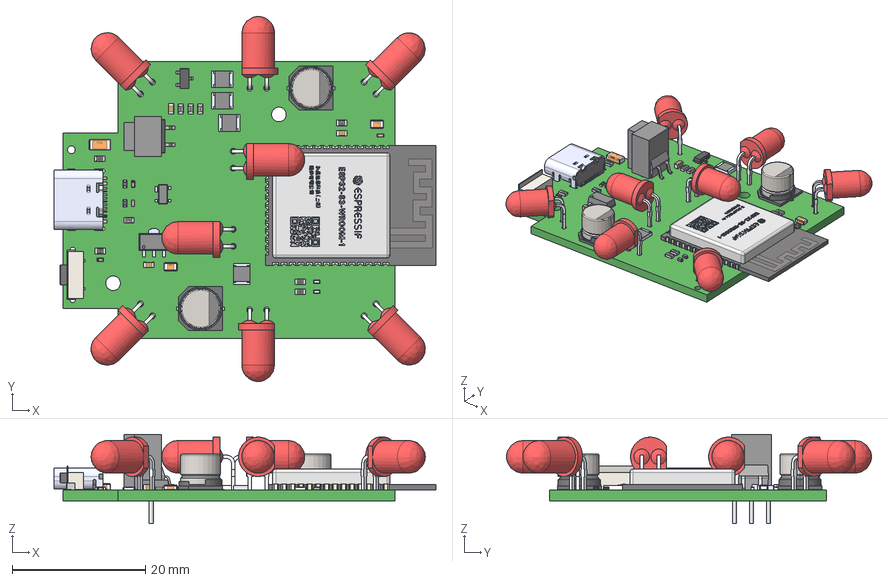
[picture p9: CAD file, 2022-12-09]
Deliverables/Supporting_files/iR-Blaster.step
57.2 x 54.7 x 13.3 mm
LED_5mm,_Red,_Thru-hole,_Right_Angle_PCB_1 x 3
LED_5mm,_Red,_Thru-hole,_Right_Angle_PCB_2 x 5
User_Library-Capacitor_0402 x 4
ERJ-14YJ201U x 4
User_Library_SOT89_5005
Leads
IRM-H638TTR2_EVE
ESP-S3-WROOM_via_v3 x 26
ESP32-S3-WROOM_shell_v11
ESP32-S3-WROOM_body_v12
ESP-S3-WROOM_via_v3(\X2\955C50CF\X0\) x 14
Switch
User_Library-RESC1608X05N x 9
User_Library-RES_1005-0402 x 2
CircuitWorks-SOT-23
User_Library-LED-0402 x 2
TYPE-C-31-M-12
SP0503BAHTG--3DModel-STEP-56544_(1)
User_Library-1206_SMD_Capacitor
User_Library-0805_SMD_Capacitor x 2
User_Library-CAPC1608X09 x 3
2202251830_ROQANG-RT1A221M0605_C267466.pdf x 2
