eSpark-Backup/ezlo-irblaster/(list of files, cad)

Other CAD files:
Deliverables/Supporting_files/iR-Blaster.DWG.DWG
Deliverables/Supporting_files/iR-Blaster.DXF
