eSpark-Backup/ezlo-irblaster/Deliverables/Schematics/Assembly Drawings_iR Blaster.pdf

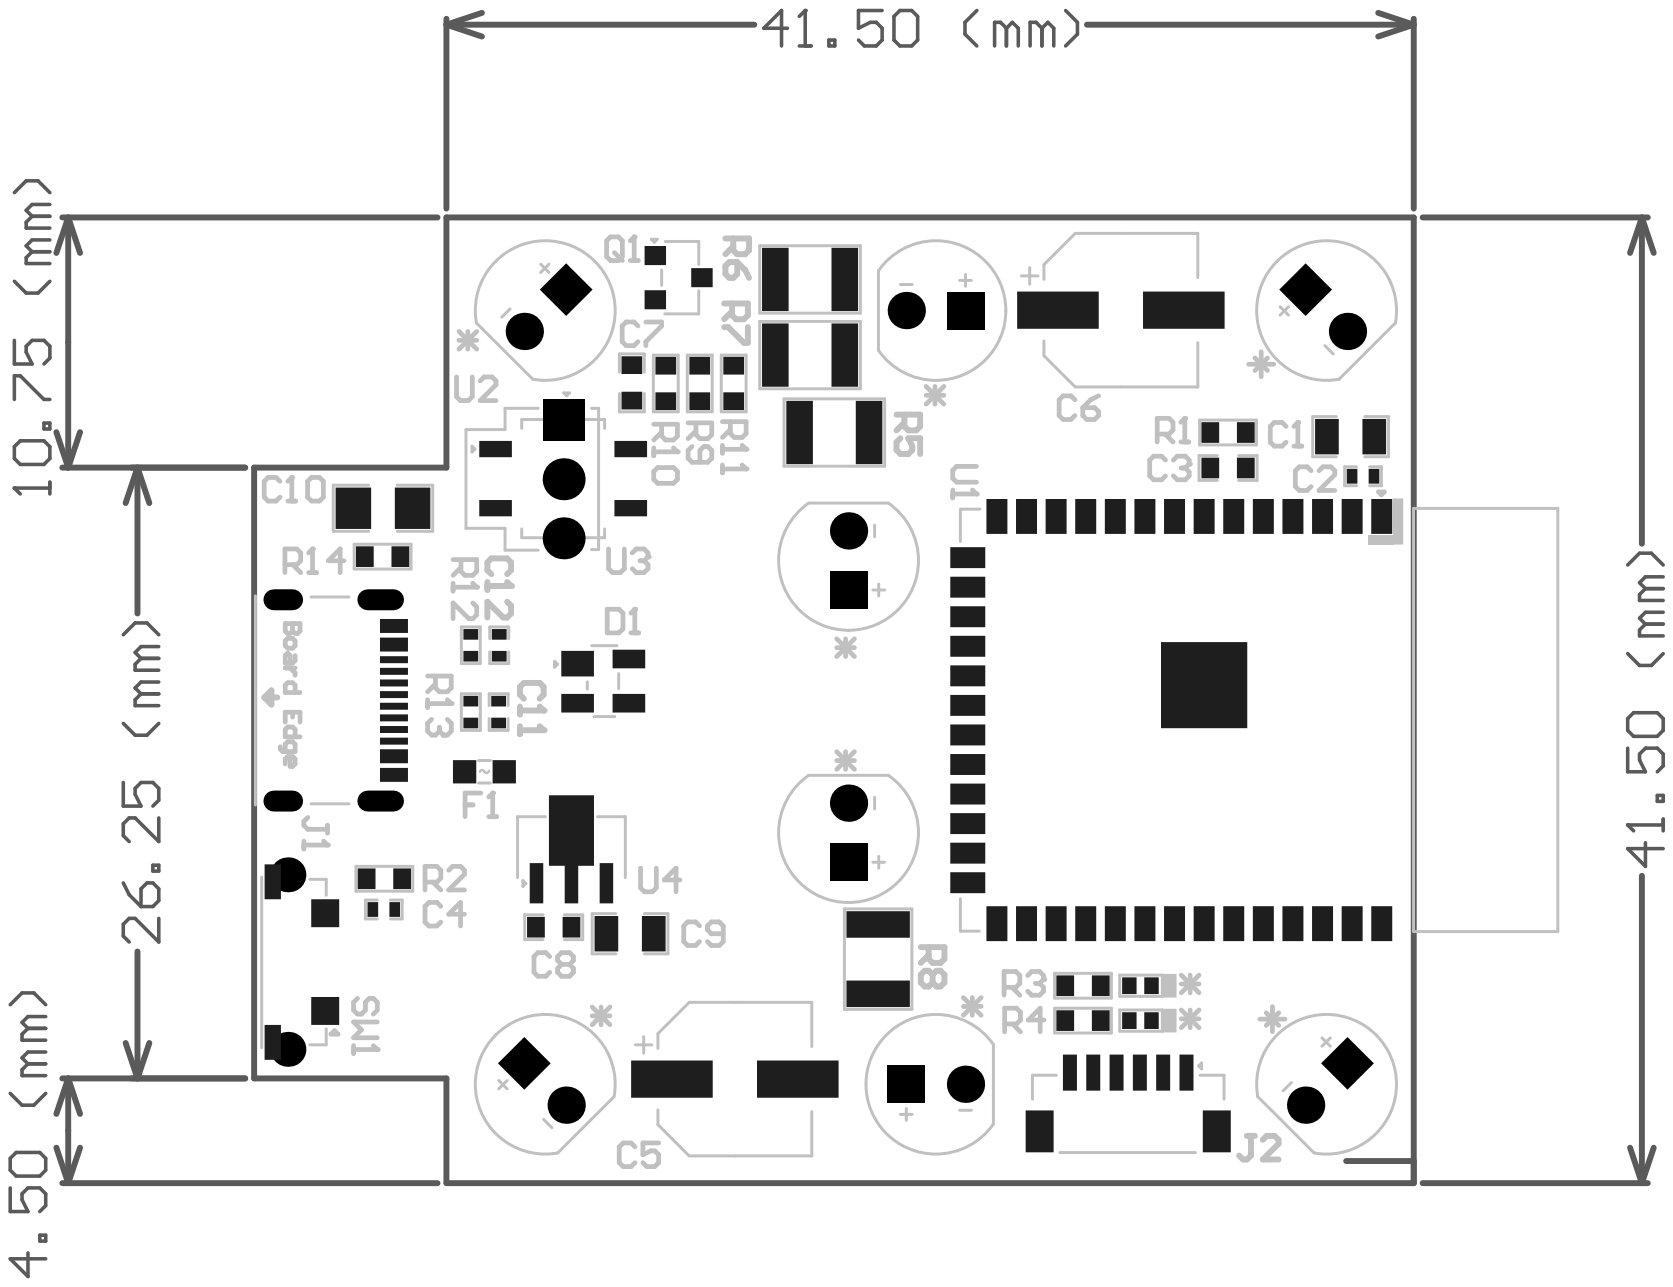
[picture p10: page 1]

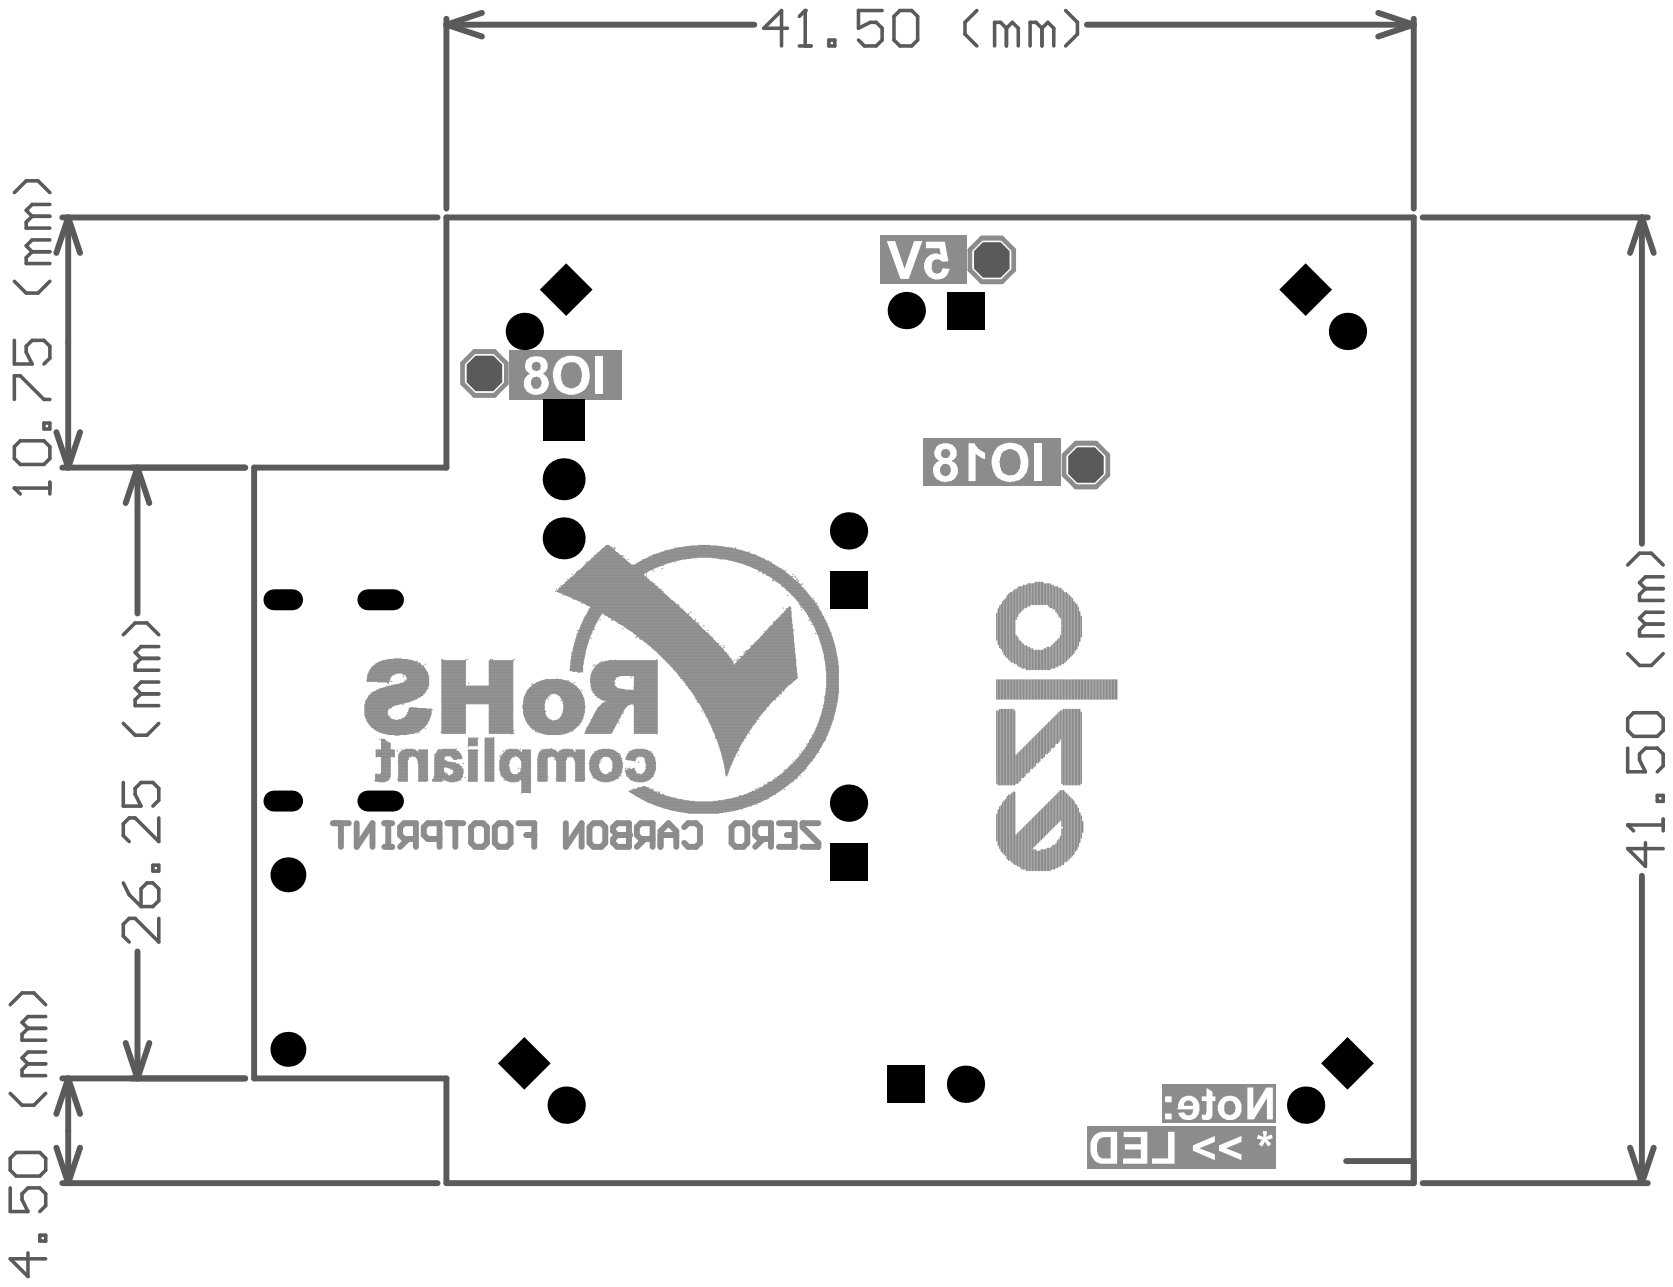
[picture p11: page 2]
