eSpark-Backup/ezlo-irblaster/Deliverables/Schematics/IR_Blaster.pdf

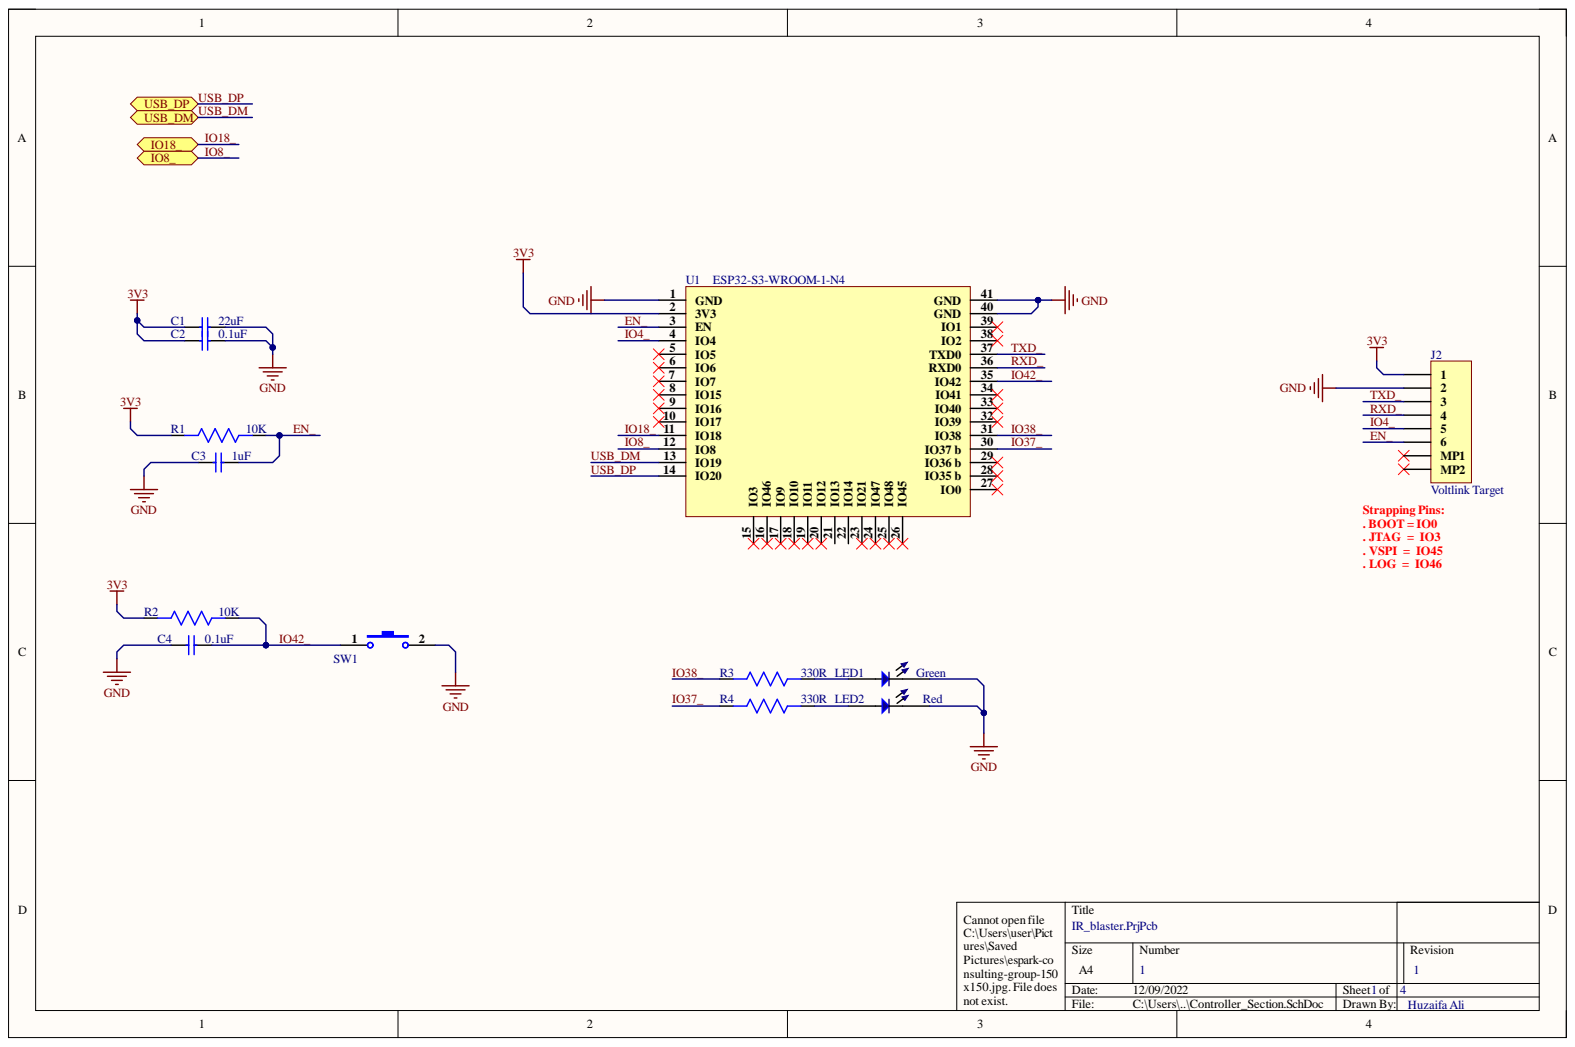
[picture p12: page 1]

C annot open file C:\Use rs\use r \P i c t ur es\S a v ed Pictur es\e s p ark-c o nsulting-group -1 5 0 x150.jpg. File does not exist. | Titl e I R_blaste r . P rj P c b

Siz e A4 | Numb e r 1 | R evisio n 1

Da te : 12/09/20 2 2 | She et of 1 | 4
File : C:\Use rs\. .\Controlle r_S e cti o n . S c hD o c | Dr awn B y | : Huz aifa A li

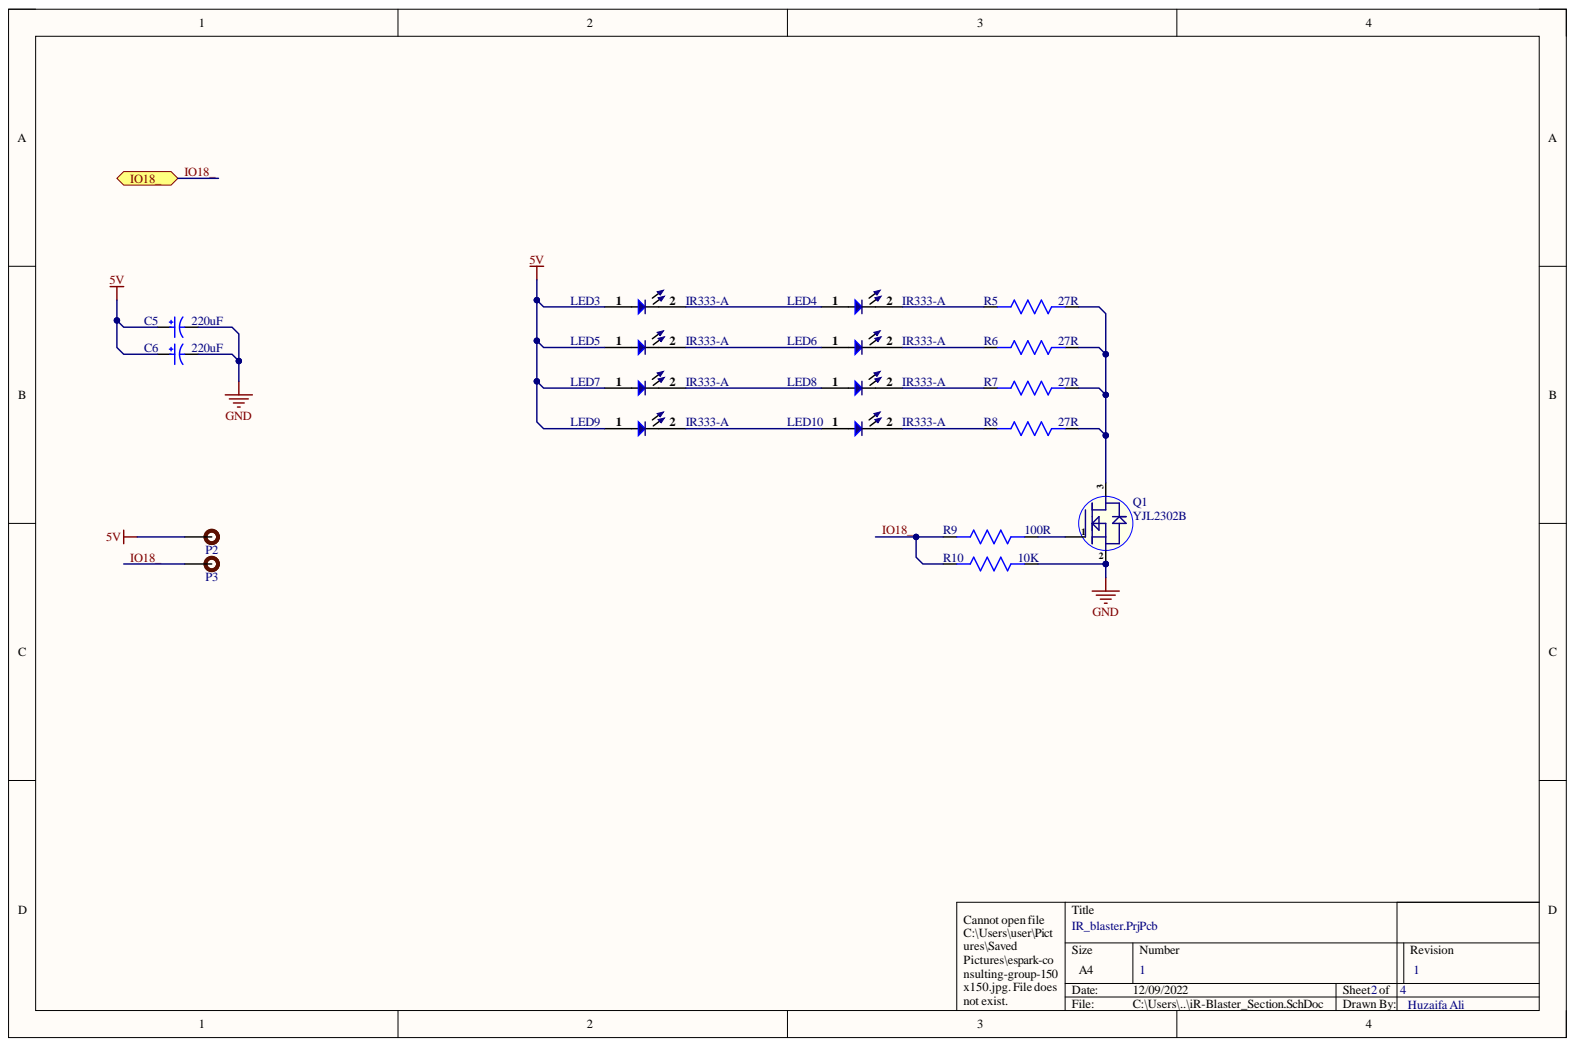
[picture p13: page 2]

Cannot open file C:\Users\user\Pict ures\Saved Pictures\espark-co nsulting-group-150 x150.jpg. File does not exist. | Title IR_blaster.PrjPcb

Size A4 | Number 1 | Revision 1

Date: 12/09/2022 | Sheet of 2 | 4
File: C:\Users\..\iR-Blaster_Section.SchDoc | Drawn By: | Huzaifa Ali

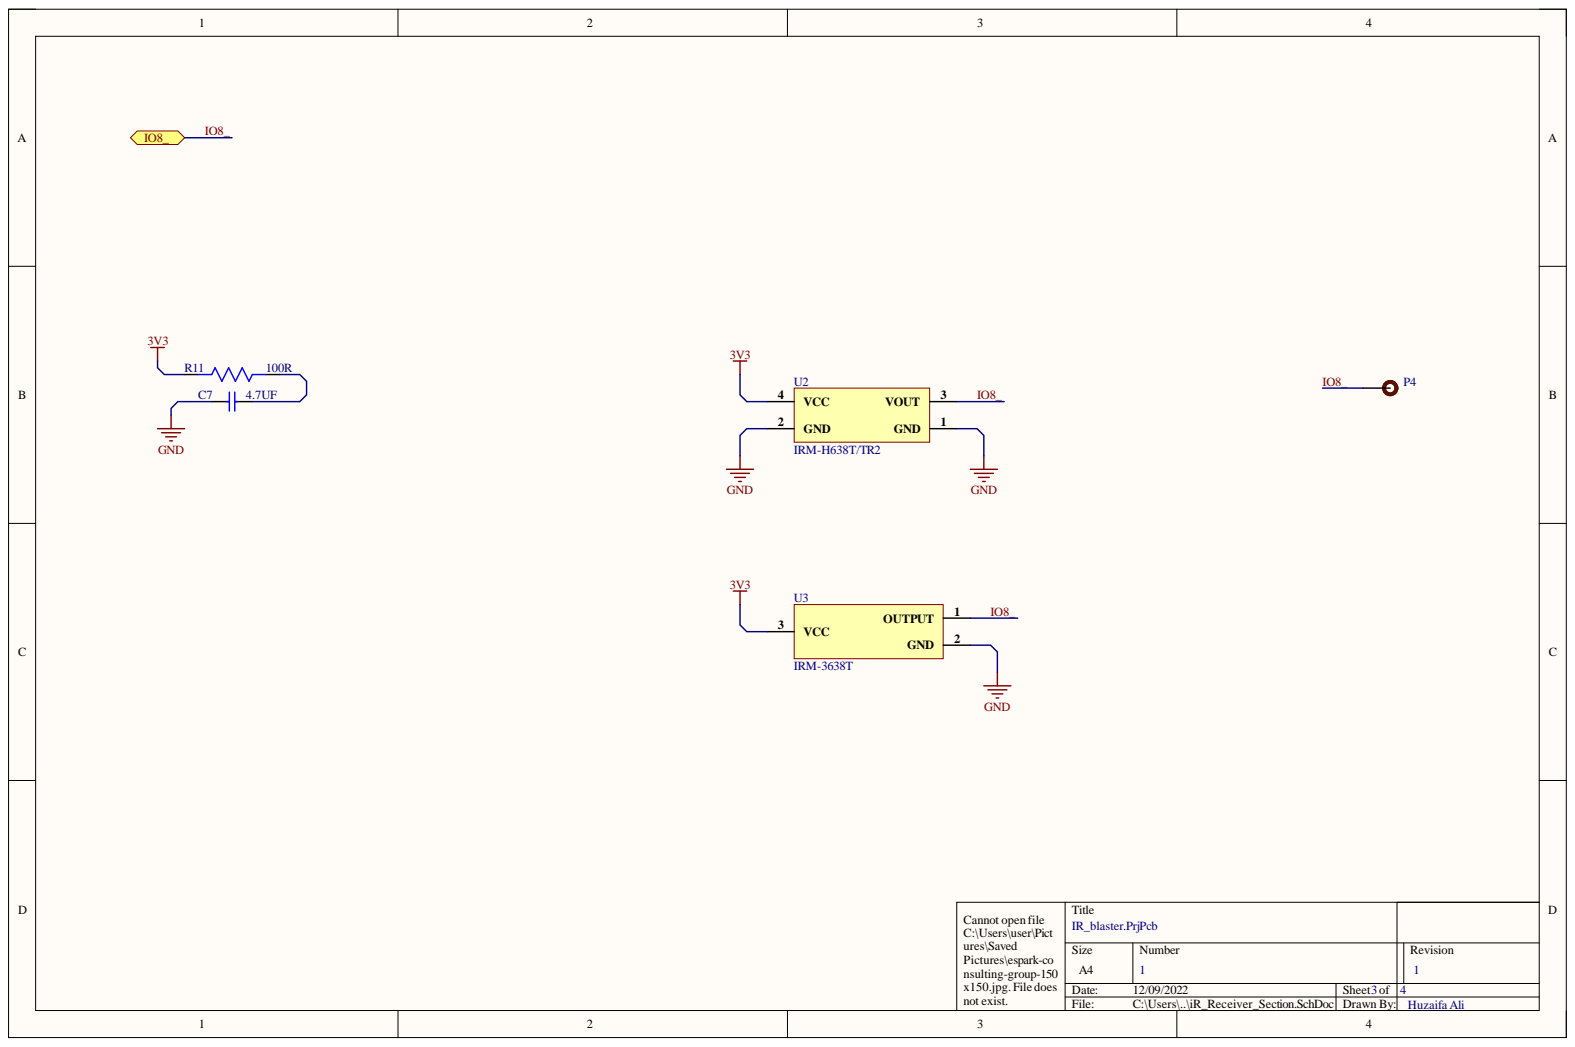
[picture p14: page 3]
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

Size A4 | Number 1 | Revision 1

Date: 12/09/2022 | Sheet of 3 | 4
File: C:\Users\..\iR_Receiver_Section.SchDoc | Drawn By: | Huzaifa Ali

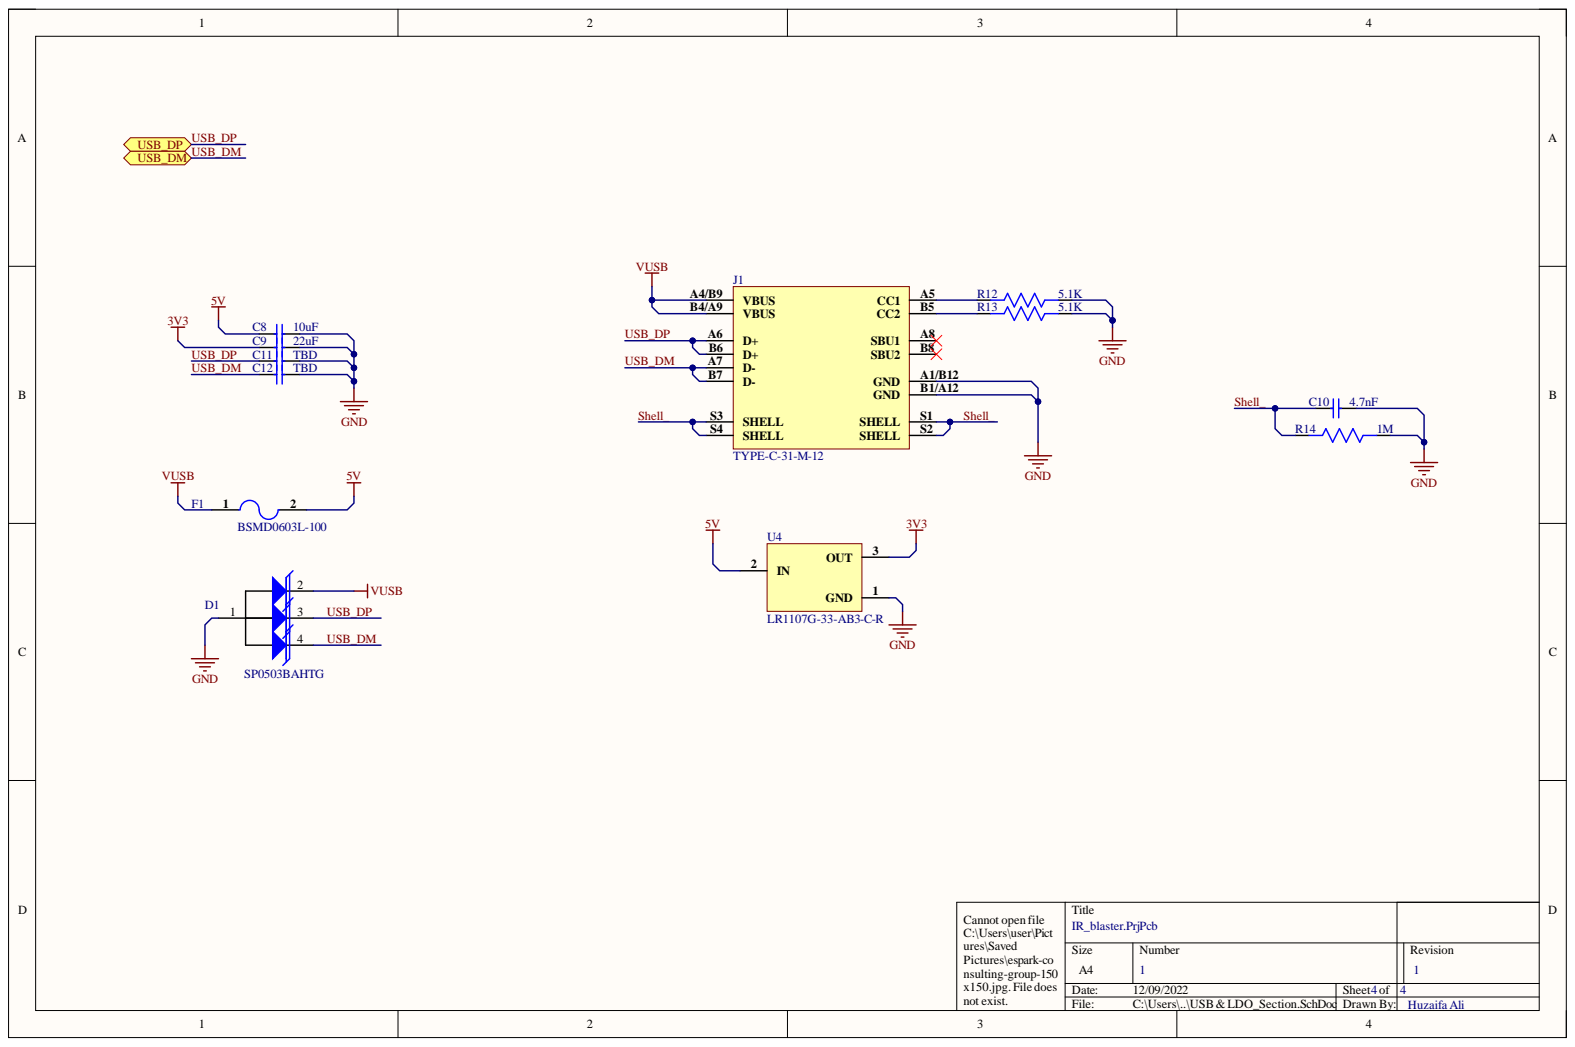
[picture p15: page 4]
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

Size A4 | Number 1 | Revision 1

Date: 12/09/2022 | Sheet of 4 | 4
File: C:\Users\..\USB& LDO_Section.SchDoc | Drawn By: | Huzaifa Ali
