eSpark-Backup/ezlo-irblaster/docs/Client's Original Design/irblaster_revB/IRBlaster_schematic_revB.pdf

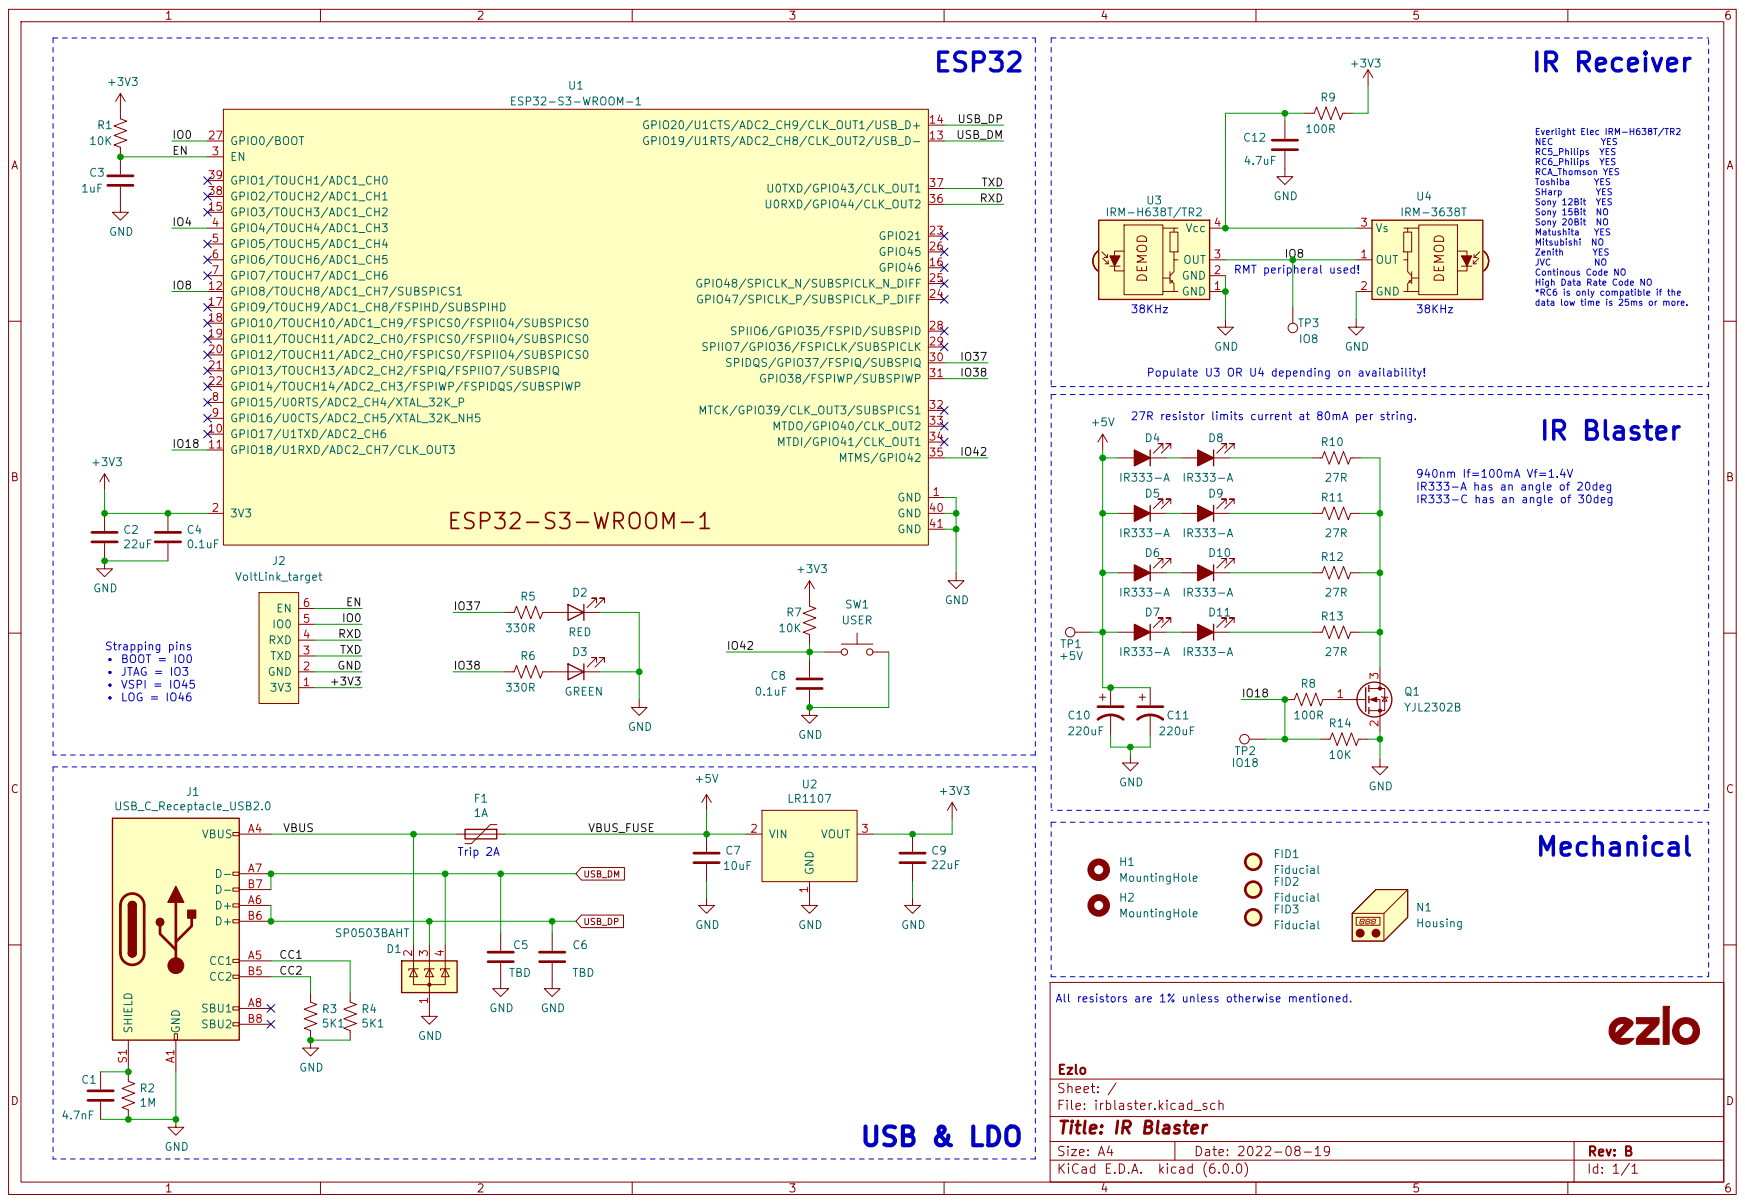
[picture p16: page 1]
