eSpark-Backup/ezlo-irblaster/(list of files, drawings)

Other design files:
Design Files/IR_blaster/Controller_Section.SchDoc
Design Files/IR_blaster/iR-Blaster.PcbDoc
Design Files/IR_blaster/iR-Blaster_Section.SchDoc
Design Files/IR_blaster/IR_blaster.PrjPcb
Design Files/IR_blaster/iR_Receiver_Section.SchDoc
Design Files/IR_blaster/Top_Sheet.SchDoc
Design Files/IR_blaster/USB & LDO_Section.SchDoc
