eSpark-Backup/ezlo-irblaster/docs/Client's Original Design/irblaster_revB/irblaster/irblaster.kicad_pcb

## KiCad design docs/Client's Original Design/irblaster_revB/irblaster/irblaster.kicad_pcb (2022-12-01)

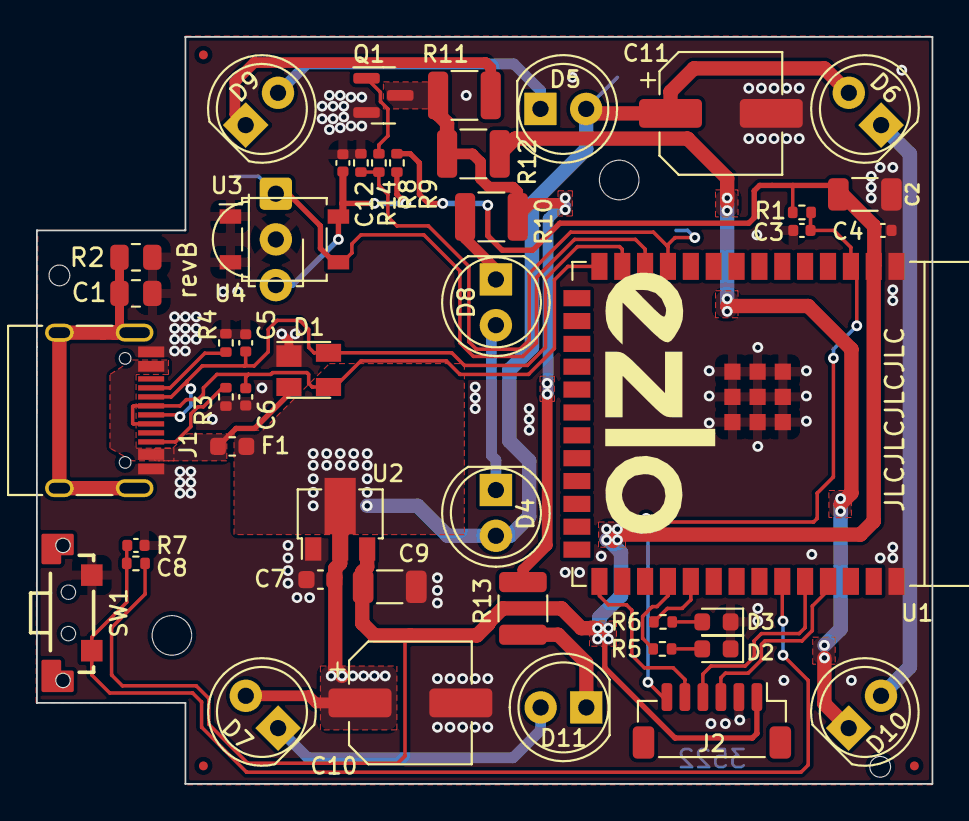
[picture p17: board irblaster.kicad_pcb from above]

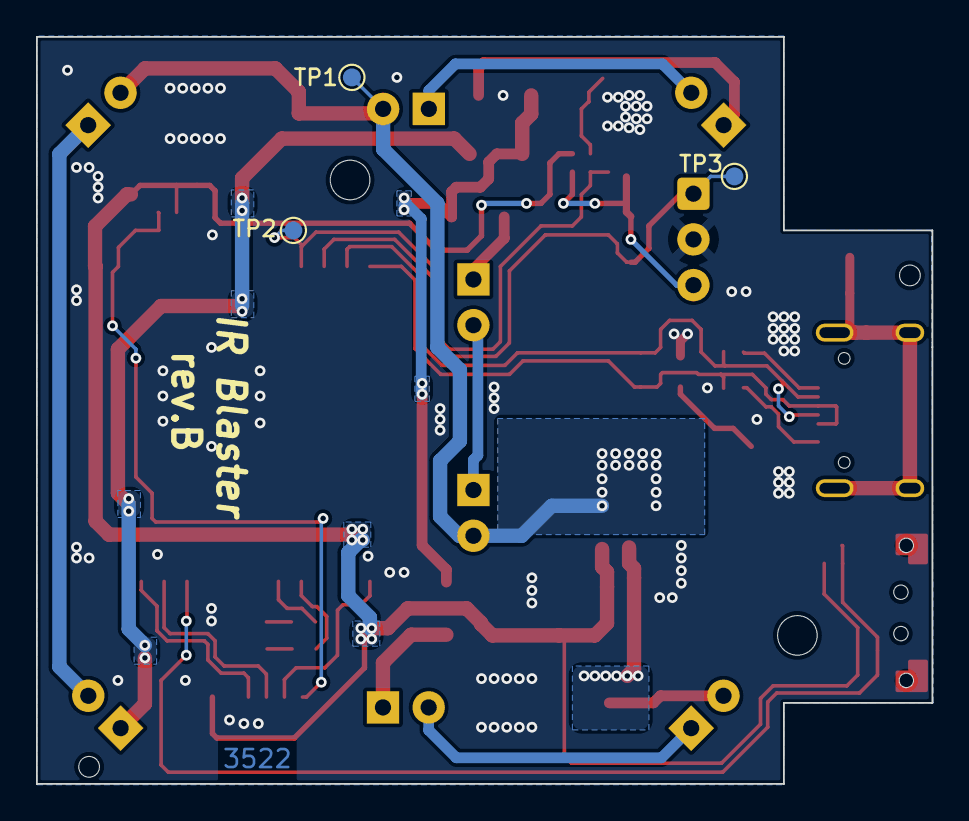
[picture p18: board irblaster.kicad_pcb from below]

Board: 2 copper layers, 49.8 x 41.5 mm, 55 parts (3 on the bottom side), 31 nets.

Parts:
C1: 4.7nF; R_0805_2012Metric
C2, C9: 22uF; C_1206_3216Metric
C3: 1uF; C_0402_1005Metric
C4, C8: 0.1uF; C_0402_1005Metric
C5, C6: TBD; C_0402_1005Metric
C7: 10uF; C_0603_1608Metric
C10, C11: 220uF; CP_Elec_6.3x5.4
C12: 4.7uF; C_0402_1005Metric
D1: SP0503BAHT; SOT-143
D2: RED; LED_0603_1608Metric
D3: GREEN; LED_0603_1608Metric
D4, D5, D6, D7, D8, D9, D10, D11: IR333-A; LED_D5.0mm
F1: 1A; Fuse_0603_1608Metric
FID1, FID2, FID3: Fiducial; Fiducial_0.5mm_Mask1mm
H1, H2: MountingHole; MountingHole_2.2mm_M2
J1: USB_C_Receptacle_USB2.0; USB_C_Receptacle_HRO_TYPE-C-31-M-12
J2: VoltLink_target; VoltLink-vertical
Q1: YJL2302B; SOT-23
R1, R7, R14: 10K; R_0402_1005Metric
R2: 1M; R_0805_2012Metric
R3, R4: 5K1; R_0402_1005Metric
R5, R6: 330R; R_0402_1005Metric
R8, R9: 100R; R_0402_1005Metric
R10, R11, R12, R13: 27R; R_1210_3225Metric
SW1: USER; Switch_YTS-B003-2A
TP1: +5V; TestPoint_Pad_D1.0mm
TP2: IO18; TestPoint_Pad_D1.0mm
TP3: IO8; TestPoint_Pad_D1.0mm
U1: ESP32-S3-WROOM-1
U2: LR1107; SOT-89-3
U3: IRM-H638T/TR2; SO-4_4.4x4.3mm_P2.54mm
U4: IRM-3638T; Vishay_MINICAST-3Pin
V1: EZLO_LOGO; Ezlo logo

Connections:
+3V3: C2.1, C4.1, C9.1, J2.1 (3V3), R1.2, R7.2, R9.1, U1.2 (3V3), U2.3 (VOUT)
+5V: C7.1, C10.1, C11.1, D4.2 (A), D5.2 (A), D6.2 (A), D7.2 (A), F1.1, TP1.1, U2.2 (VIN)
/CC1: J1.A5 (CC1), R4.1
/CC2: J1.B5 (CC2), R3.1
/EN: C3.1, J2.6 (EN), R1.1, U1.3 (EN)
/IO0: J2.5 (IO0), U1.27 (GPIO0/BOOT)
/IO8: TP3.1, U1.12 (GPIO8/TOUCH8/ADC1_CH7/SUBSPICS1), U3.3 (OUT), U4.1 (OUT)
/IO18: R8.2, R14.2, TP2.1, U1.11 (GPIO18/U1RXD/ADC2_CH7/CLK_OUT3)
/IO37: R5.2, U1.30 (SPIDQS/GPIO37/FSPIQ/SUBSPIQ)
/IO38: R6.2, U1.31 (GPIO38/FSPIWP/SUBSPIWP)
/IO42: C8.2, R7.1, SW1.1, U1.35 (MTMS/GPIO42)
/RXD: J2.4 (RXD), U1.36 (U0RXD/GPIO44/CLK_OUT2)
/TXD: J2.3 (TXD), U1.37 (U0TXD/GPIO43/CLK_OUT1)
/VBUS: D1.2 (K), F1.2, J1.A4 (VBUS), J1.A9 (VBUS), J1.B4 (VBUS), J1.B9 (VBUS)
GND: C1.2, C2.2, C3.2, C4.2, C5.2, C6.2, C7.2, C8.1, C9.2, C10.2, C11.2, C12.2, D1.1 (A), D2.1 (K), D3.1 (K), J1.A1 (GND), J1.A12 (GND), J1.B1 (GND), J1.B12 (GND), J2.2 (GND), Q1.2 (S), R2.2, R3.2, R4.2, R14.1, SW1.2, U1.1 (GND), U1.40 (GND), U1.41 (GND), U2.1 (GND), U3.1 (GND), U3.2 (GND), U4.2 (GND)
unnamed: C1.1, J1.S1 (SHIELD), R2.1
unnamed: C12.1, R9.2, U3.4 (Vcc), U4.3 (Vs)
unnamed: D2.2 (A), R5.1
unnamed: D3.2 (A), R6.1
unnamed: D4.1 (K), D8.2 (A)
unnamed: D5.1 (K), D9.2 (A)
unnamed: D8.1 (K), R10.2
unnamed: D9.1 (K), R11.2
unnamed: D10.1 (K), R12.2
unnamed: D6.1 (K), D10.2 (A)
unnamed: D11.1 (K), R13.2
unnamed: D7.1 (K), D11.2 (A)
unnamed: Q1.1 (G), R8.1
unnamed: Q1.3 (D), R10.1, R11.1, R12.1, R13.1
USB_DM: C5.1, D1.4 (K), J1.A7 (D-), J1.B7 (D-), U1.13 (GPIO19/U1RTS/ADC2_CH8/CLK_OUT2/USB_D-)
USB_DP: C6.1, D1.3 (K), J1.A6 (D+), J1.B6 (D+), U1.14 (GPIO20/U1CTS/ADC2_CH9/CLK_OUT1/USB_D+)
