eSpark-Backup/ezlo-irblaster/(commit log)

2022-12-01 client files pushed
    [BOM revA.xls, IRBlaster_BOM_revB.xlsx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]
2022-12-01 #1 In progress
    [Connector_Section.SchDoc, Controller_Section.SchDoc, IR_blaster.PrjPcb, Top_Sheet.SchDoc, iR-Blaster.PcbDoc, iR-Blaster_Section.SchDoc, iR_Receiver_Section.SchDoc, irblaster.csv]
2022-12-02 #1 Schematic Completed PCB in progress
    [Connector_Section.SchDoc, Controller_Section.SchDoc, IR_blaster.PrjPcb, USB & LDO_Section.SchDoc, iR-Blaster.PcbDoc, iR-Blaster_Section.SchDoc, iR_Receiver_Section.SchDoc]
2022-12-07 #1 In Progess.
    [Controller_Section.SchDoc, USB & LDO_Section.SchDoc, iR-Blaster.PcbDoc, iR-Blaster_Section.SchDoc, iR_Receiver_Section.SchDoc]
2022-12-08 #2 Done.
    [Controller_Section.SchDoc, IR_blaster.PrjPcb, USB & LDO_Section.SchDoc, iR-Blaster.PcbDoc, iR-Blaster_Section.SchDoc, iR_Receiver_Section.SchDoc, irblaster.kicad_pcb]
2022-12-09 #3 Done.
    [Controller_Section.SchDoc, USB & LDO_Section.SchDoc, iR-Blaster.PcbDoc, iR-Blaster_Section.SchDoc, iR_Receiver_Section.SchDoc]
2022-12-09 #2 PCB Logo Added
    [Controller_Section.SchDoc, IR_blaster.PrjPcb, USB & LDO_Section.SchDoc, iR-Blaster.PcbDoc, iR-Blaster_Section.SchDoc, iR_Receiver_Section.SchDoc]
2022-12-09 #4 Completed.
    [Controller_Section.SchDoc, IR_blaster.PrjPcb, Pick Place for iR-Blaster.csv, USB & LDO_Section.SchDoc, iR-Blaster.DWG.DWG, iR-Blaster.DXF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]
2022-12-12 #5 In progress.
    [IR_blaster.PrjPcb, eSpark_BOM.xlsx]
2022-12-13 #5 In progress
    [eSpark_BOM.xlsx]
